HazenBabcock/revopoint-lat-lon-scanner/README.md

# revopoint-lat-lon-scanner

A two-axis stage that turns an object in front of a fixed Revopoint MINI 3D
scanner: a turntable (longitude) carried on a tilting cradle (latitude). Both
axes are stepper motors driven by a BigTreeTech SKR Mini E3 V3.0.

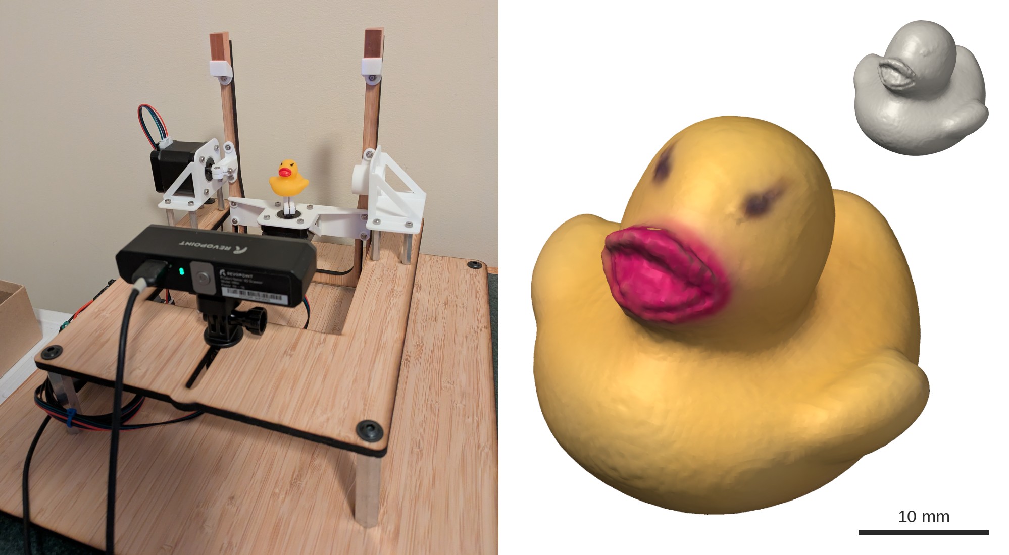
[picture p1: images/overview.jpg]
The stage with a rubber duck on the turntable, and the duck's scanned mesh in color and in gray


Left: the stage, with the scanner in front and a rubber duck on the turntable.
Right: the duck's mesh as the reconstruction builds it
([`examples/duck_color_mesh.ply`](examples/duck_color_mesh.ply)), colored from
the scanner's color camera. The same mesh without color (top right) shows the
scanned surface. The scale bar is for the color render. The
[example viewer](https://hazenbabcock.github.io/revopoint-lat-lon-scanner/examples/)
turns it around in 3D in the browser.

- [`firmware/`](firmware/) - Marlin configuration and build script for the
  board, which then takes G-code over USB. Licensed separately under the GPLv3.
- [`lat_lon_scanner/`](https://github.com/HazenBabcock/revopoint-lat-lon-scanner/tree/main/lat_lon_scanner) -
  Python package that drives the stage and the scanner.
- [`cad/`](cad/) - FreeCAD models of the stage, the DXF and STL files sent out
  for fabrication, and the bill of materials.
- [`examples/`](examples/) - some example scans, as point clouds and colored
  meshes, and a [3D viewer](https://hazenbabcock.github.io/revopoint-lat-lon-scanner/examples/)
  for them.
- [`notes/agent-guide.md`](notes/agent-guide.md) - a guide for AI agents working with this repository.

## Requirements

All access to the scanner goes through
[revopoint-python](https://github.com/HazenBabcock/revopoint-python), which
talks to the Revopoint MINI over WiFi: depth capture, exposure control and its
calibration files. It is not on PyPI, so install it from a checkout first:

```bash
git clone https://github.com/HazenBabcock/revopoint-python.git
pip install -e revopoint-python
```

Then install this package, with the extras for reconstruction and tests:

```bash
pip install -e ".[reconstruct,test]"
```

## Scanning

After powering up the stage, energize the motors, push the cradle upright by
hand (the motors hold it there), and declare that pose as zero:

```bash
python -m lat_lon_scanner.stage zero
```

Then scan. Each run goes to `~/Data/revopoint/<date>/<name>/`, with one `.npz`
per view holding the depth frames and stereo images at each exposure, and a
frame from the scanner's color camera (`--no-color` skips it). For color, light
the object with a steady lamp (see [Color](#color)):

```bash
python -m lat_lon_scanner.capture duck
```

The default plan is latitudes +90, +60, +30, 0 and −20, with each row's
longitudes spaced so neighboring views are about 30° of arc apart on the sphere
(`--spacing`): 1, 6, 10, 12 and 11 views, 40 in all at about 18 s each. Each
view captures 4 depth frames at each of three exposures (12000, 24000, 40000),
and the color frame during the 24000 one (or the exposure nearest it).

Those exposures suit yellow, red and darker objects. White and light objects
saturate at them: a white nylon part
([`examples/3d_printed_part_mesh.ply`](examples/3d_printed_part_mesh.ply)) got
depth on only 0.1–2% of each frame at 12000 and 24000, but 92–95% at any one
exposure from 2000 to 8000. Scan such objects with `--exposures 3000 6000`.

`python -m lat_lon_scanner.stage` also takes `position`,
`move <latitude> <longitude>` and `release`.

## Reconstruction

```bash
python -m lat_lon_scanner.reconstruct ~/Data/revopoint/<date>/duck
```

This needs the `reconstruct` extras (Open3D, SciPy) and writes
`reconstruction/` inside the run: `point_cloud.ply` (positions in mm, normals,
and color, or the scanner's grayscale brightness for runs without color
frames), `mesh.ply` (a triangle mesh fitted to the points, colored the same
way; `--no-mesh` skips it), `stage_axes.json`, `fit.npz`, and `preview_*.png` renderings
from six directions.

The stage needs no separate calibration. The two rotation axes are fitted from
the scan itself, by minimizing how far neighboring views disagree once each is
turned back by its commanded angles. On the first duck scan the axes came out
0.5 mm from intersecting, and neighboring views agreed to about 0.3 mm. Each
view is filtered (pixels at depth edges and surfaces seen nearly edge-on are
dropped), the views are merged, and the result is cropped to the object: the
post and cap it sits on are found as a stack of cylinders on the turntable axis
and cut away. Yellow surfaces reflect little of the scanner's blue light and
need long exposures. Some surfaces give little depth even then: the duck's pink
beak got depth on only 10–33% of its pixels in any one view at 60000, so expect
holes there.

The mesh is fitted with Poisson surface reconstruction, which bridges holes
like those in the beak. Poisson also closes the opening where the mount was
cut away, with surface no point supports, so the mesh is trimmed back to
within 1 mm of the points. Holes wider than about 2 mm keep an opening.

An object on a soft mount also tips as the cradle tilts. The bust, held on its
cap by a gel pad about 0.5 mm thick, leaned toward the scanner at high
latitudes and away at negative ones, which left its head in layers 1–2 mm
apart. So after the axes, the reconstruction fits a nod that grows with the
gravity load, gain × sin(latitude), about a pivot on the turntable axis, and
then refits the axes with it. For the bust the nod came out 2.5° at latitude 90,
and the misalignment of views up to 70° apart fell from 0.53 to 0.46 mm; for
the duck it was 0.5°, with little effect. The bust's 88 views take about 10
minutes to reconstruct, 5 of them for the nod.

A soft mount can also let the object shift in single views: the bust moved by
up to 2 mm during its +50 row. So each view's pose is then refined with a
joint ICP over neighboring views, starting from the fitted model
(`--no-refine` skips it; it takes a minute or two). On the bust the head's
surface went from layers about 0.3 mm thick to one layer under 0.1 mm; on the
duck it made little difference.

### Color

Each point of the cloud, and each vertex of the mesh, is colored from every
view's color frame that sees it. It is projected into the frame using the
color camera's calibration stored on the scanner. It counts as unseen if it
faces away or something nearer hides it (the color camera sits 15 mm from the
depth camera, so it sees around edges differently). The colors are white
balanced and averaged over the frames, each weighted by how squarely the
surface faces the camera. A point takes color even from views that got no
depth there, which matters for surfaces like the duck's beak. The color camera
only runs while the projector does, so its frames carry faint projector
stripes. These stay put in the frame while the object turns under them, so
averaging over views removes them.

Scan under a steady lamp aimed at the object from the scanner's side:

- The color camera's exposure and white balance are automatic and can't be
  set, so in daylight the colors drift as clouds pass.
- Next to a lamp the projector's light is weak. Without one it can dominate,
  and some dyes fluoresce in it: the duck's yellow came out green.

The white balance gains (`color_white_balance_gains` in `reconstruct.py`)
were measured from the gray patches of a color card held where the object sits,
under the lamp used for the duck. A different light needs new gains. The camera
also seems to see near-infrared, which mutes some colors (it reads a navy
patch as brown and a green one as gray), so a full color fit to the card's
patches did worse than the white balance alone. An LED lamp, with little
infrared, may give cleaner color than an incandescent one.

Now and then a whole session's frames have far less blue than those gains
expect, and the reconstruction warns about extreme cases. One such run turned a
light tan flower pot yellow-green and its light purple flowers tan, for no known
reason.
`--white-from-mount` then takes the white balance and brightness from the
run's own white nylon post and cap instead. It isn't the default because the
fixed gains look better on normal runs. A rescan after power-cycling the scanner
brought back normal color. Each view also records the white balance gains the
camera was using, and the reconstruction reports them.

### Filling in a dark area

A dark area, such as the duck's red beak, keeps getting depth at longer
exposures after the rest of the object has stopped improving. Rather than
rescanning everything, scan just that area at 60000 (the top of the scanner's
useful range) as a second run, without moving the scanner or re-zeroing the
stage, then merge it in:

```bash
python -m lat_lon_scanner.capture duck_beak --exposures 60000 \
    --poses "-15:-37 -15:-22 -15:-7 -15:8 -15:23 0:23 0:8 0:-7 0:-22 0:-37"
python -m lat_lon_scanner.reconstruct ~/Data/revopoint/<date>/duck \
    --extra-runs ~/Data/revopoint/<date>/duck_beak --output-name reconstruction_with_beak
```

The extra run's views are placed using the axes fitted from the main run. For
the duck, 20 views around the beak took 3 minutes, lined up with the main scan
as well as its own views do (about 0.1 mm), and nearly doubled the points
within 5 mm of the beak's center.

New angles are what help. Repeating a pose fills the same pixels again: three
captures of one beak pose together covered only 3–4 points more of it than the
best one alone. Turning the lamp off helped a little at 60000 (the beak got
depth on 24% and 33% of its pixels at two poses, against 21% and 27% with the
lamp), because the lamp adds brightness without adding stripe contrast. An
extra run's color frames color the object too, so capture a lamp-off run with
`--no-color`. What holes remain, the mesh bridges.

### Larger objects

The duck was scanned with the scanner at the front of its mount slot, which
puts the rotation center about 120 mm away; there the view is only about
54 mm tall. For a larger object, slide the scanner back along the slot. At the
back the rotation center is about 176 mm away, the view about 79 mm tall, and
a bust about 70 mm tall fit at every pose from latitude −20 to +90. The
scanner's working distance is 100–200 mm.

The reconstruction defaults are set for the duck, so give it the new distances:

```bash
python -m lat_lon_scanner.reconstruct ~/Data/revopoint/<date>/bust --depth-range 100 215 --crop-radius 55
```

`--depth-range` keeps depth readings between those distances from the scanner,
in mm (default 73–194). `--crop-radius` keeps points within that distance of
the rotation center, in mm (default 32).

### Round objects

The mount is found by its round cross-section, so a round object centered on
the turntable axis, such as a small flower pot, can pass for it and be cut
away. The reconstruction warns when the mount's top comes within 5 mm of the
rotation center. If the object lost its lower part, give the height of the
cap's top yourself, in mm along the turntable axis from the rotation center
(negative is below it). Everything above it is kept:

```bash
python -m lat_lon_scanner.reconstruct ~/Data/revopoint/<date>/flower_pot --mount-top -8.5
```

### Redoing only the last steps

Most of a reconstruction's time goes to fitting the stage and refining the
views. To change only what comes after, such as the mount cut or the white
balance, take those from an earlier output (its `fit.npz`) with `--reuse-fit`:

```bash
python -m lat_lon_scanner.reconstruct ~/Data/revopoint/<date>/flower_pot --reuse-fit reconstruction \
    --mount-top -8.5 --output-name reconstruction_with_pot
```

## Tests

```bash
python -m pytest tests
```

## Stage conventions

Positions are in degrees. Zero is the cradle upright (turntable axis vertical),
set with `G92 X0 Y0` after each power-up since there are no limit switches.

| Axis | Motion | Positive direction | Hard limit | Scanning range |
|---|---|---|---|---|
| X | Latitude (tilt) | Top of the stage tilts toward the scanner | ±90° | +90° to −20° |
| Y | Longitude (turntable) | Counterclockwise seen from above (cradle upright) | None | Any |

- The latitude hard limit is set by the longitude motor's cable, which winds
  onto the apparatus beyond ±90°.
- Below −20° the scanner mostly sees the underside of the mount and the
  turntable plate.
- Turning the object counterclockwise moves the scanner's viewpoint clockwise
  around it, so +Y lowers the viewpoint's longitude on the object.

## CAD

[`cad/`](cad/) has the FreeCAD 1.1 models of the stage, the files sent out for
fabrication, and the bill of materials
([`scanner_mount_bom.xlsx`](cad/scanner_mount_bom.xlsx)). The assemblies also use models that can't be redistributed
here, so FreeCAD opens them with those parts missing:

- The scanner, from [Revopoint Mini](https://grabcad.com/library/revopoint-mini-1)
  and [Revopoint - Pop 3 Set](https://grabcad.com/library/revopoint-pop-3-1) on
  GrabCAD.
- The control board, from BigTreeTech's
  [SKR Mini E3 repository](https://github.com/bigtreetech/BIGTREETECH-SKR-mini-E3/tree/master/hardware/BTT%20SKR%20MINI%20E3%20V3.0/3D).
- The example object, from
  [Small bust scanned with Revopoint MINI](https://grabcad.com/library/small-bust-scanned-with-revopoint-mini-1)
  on GrabCAD.
- The motors and hardware, from McMaster-Carr.

[`cad/README.md`](cad/README.md) lists each missing file and McMaster-Carr part
number.

## License

MIT (see `LICENSE`), except `firmware/`, which is derived from Marlin and
licensed under the GPLv3 (see `firmware/LICENSE`).
