HazenBabcock/revopoint-lat-lon-scanner/cad/scanner_mount_bom.xlsx

Sheet: McMaster order
Revopoint scanner mount - McMaster-Carr order list
Quantities are for one complete build, counted from every instance in assembly.FCStd (model saved 11 Oct 2026). The copper bar and the washers are added by hand (see Notes).
Qty | Part number | Type | Description | Size | Where used
Screws
4 | 91292A109 | Screw | 18-8 stainless socket head cap screw | M3 x 0.5 mm, 4 mm long | M3 x 8 mm standoff kit
16 | 91292A111 | Screw | 18-8 stainless socket head cap screw | M3 x 0.5 mm, 6 mm long | M3 x 31 mm standoff kit; Latitude stepper motor assembly; Longitude stepper motor assembly
2 | 91292A112 | Screw | 18-8 stainless socket head cap screw | M3 x 0.5 mm, 8 mm long | Lat/lon stage assembly; Longitude stepper mount assembly
12 | 91292A113 | Screw | 18-8 stainless socket head cap screw | M3 x 0.5 mm, 10 mm long | M3 x 8 mm standoff kit; M3 x 31 mm standoff kit
10 | 91292A114 | Screw | 18-8 stainless socket head cap screw | M3 x 0.5 mm, 12 mm long | Lat/lon stage assembly; Longitude stepper mount assembly
12 | 91355A081 | Screw | Black-oxide alloy steel flanged button head screw | 1/4"-20, 1/2" long | Foot bumper; 1/4"-20 x 63.5 mm standoff kit
Nuts
12 | 94150A325 | Nut | 316 stainless hex nut | M3 x 0.5 mm, 5.5 mm wide, 2.4 mm thick | Lat/lon stage assembly; Longitude stepper mount assembly
Washers
2 | 96659A106 | Washer | 18-8 stainless SAE washer | 1/4" screw size, 0.281" ID, 0.625" OD | Scanner mount (not modeled)
Standoffs
4 | 95947A004 | Standoff | Aluminum female-threaded hex standoff | M3 x 0.5 mm, 8 mm long, 4.5 mm hex | M3 x 8 mm standoff kit
8 | 95947A063 | Standoff | Aluminum female-threaded hex standoff | M3 x 0.5 mm, 31 mm long, 6 mm hex | M3 x 31 mm standoff kit
4 | 91780A363 | Standoff | Aluminum female-threaded hex standoff | 1/4"-20, 2-1/2" (63.5 mm) long, 1/2" hex | 1/4"-20 x 63.5 mm standoff kit
Bumpers
4 | 9546K551 | Bumper | Neoprene bumper, threaded stud/insert | 3/4" dia x 5/8" high, 1/4"-20 | Foot bumper
Knobs
1 | 7129T33 | Knob | Black phenolic five-arm knob | 32.6 mm across arms, approx. 5/16" threaded bore | Top level (assembly)
Bar stock
1 | 89275K36 | Bar | Multipurpose 110 copper bar | 1/2" thick, 1/2" wide, 1/2 ft (6") long | Counterweights: cut into two ~1.25" (32 mm) pieces
92 |  |  | Total McMaster pieces

Sheet: Full BOM
Revopoint scanner mount - full bill of materials
Qty | Part ref. | Type | Description | Size | Source
McMaster-Carr hardware
4 | 9546K551 | Bumper | Neoprene bumper, threaded stud/insert | 3/4" dia x 5/8" high, 1/4"-20 | McMaster-Carr
1 | 7129T33 | Knob | Black phenolic five-arm knob | 32.6 mm across arms, approx. 5/16" threaded bore | McMaster-Carr
12 | 94150A325 | Nut | 316 stainless hex nut | M3 x 0.5 mm, 5.5 mm wide, 2.4 mm thick | McMaster-Carr
16 | 91292A111 | Screw | 18-8 stainless socket head cap screw | M3 x 0.5 mm, 6 mm long | McMaster-Carr
12 | 91292A113 | Screw | 18-8 stainless socket head cap screw | M3 x 0.5 mm, 10 mm long | McMaster-Carr
12 | 91355A081 | Screw | Black-oxide alloy steel flanged button head screw | 1/4"-20, 1/2" long | McMaster-Carr
10 | 91292A114 | Screw | 18-8 stainless socket head cap screw | M3 x 0.5 mm, 12 mm long | McMaster-Carr
4 | 91292A109 | Screw | 18-8 stainless socket head cap screw | M3 x 0.5 mm, 4 mm long | McMaster-Carr
2 | 91292A112 | Screw | 18-8 stainless socket head cap screw | M3 x 0.5 mm, 8 mm long | McMaster-Carr
8 | 95947A063 | Standoff | Aluminum female-threaded hex standoff | M3 x 0.5 mm, 31 mm long, 6 mm hex | McMaster-Carr
4 | 91780A363 | Standoff | Aluminum female-threaded hex standoff | 1/4"-20, 2-1/2" (63.5 mm) long, 1/2" hex | McMaster-Carr
4 | 95947A004 | Standoff | Aluminum female-threaded hex standoff | M3 x 0.5 mm, 8 mm long, 4.5 mm hex | McMaster-Carr
2 | 96659A106 | Washer | 18-8 stainless SAE washer | 1/4" screw size, 0.281" ID, 0.625" OD | McMaster-Carr
Laser-cut plates
1 |  | Plate | Base plate | 374 x 352 x 6.7 mm | Ponoko - 6.7mm Amber Bamboo Plywood - Laser Cutting
1 |  | Plate | Lat/lon plate | 230 x 140 x 6.7 mm | Ponoko - 6.7mm Amber Bamboo Plywood - Laser Cutting
1 |  | Plate | Scanner mount plate | 268 x 228 x 6.7 mm | Ponoko - 6.7mm Amber Bamboo Plywood - Laser Cutting
3D printed parts
2 |  | Printed part | Counterweight clamp | 22.5 x 14.9 x 14.7 mm | Xometry - Nylon 12, White, Color: As Printed, Off White (Natural)
2 |  | Printed part | Latitude stepper mount | 76 x 40 x 50 mm | Xometry - Nylon 12, White, Color: As Printed, Off White (Natural)
1 |  | Printed part | Longitude stepper mount | 138 x 30 x 50 mm | Xometry - Nylon 12, White, Color: As Printed, Off White (Natural)
1 |  | Printed part | Latitude idle arm | 37.8 x 40 x 23 mm | Xometry - Nylon 12, White, Color: As Printed, Off White (Natural)
1 |  | Printed part | Latitude stepper arm | 38.0 x 40 x 16 mm | Xometry - Nylon 12, White, Color: As Printed, Off White (Natural)
1 |  | Printed part | Longitude plate | 20.0 x 15 x 20 mm | Xometry - Nylon 12, White, Color: As Printed, Off White (Natural)
Cut from bar stock
2 |  | Bar stock | Counterweight, cut from copper bar | 1/2" x 1/2" x about 1.25" (32 mm) long | Cut from McMaster-Carr 89275K36 (see McMaster order)
Purchased electronics and motors
1 |  | Electronics | BigTreeTech SKR Mini E3 V3.0 stepper controller board | 105.3 x 70.3 x 18.2 mm | Purchased
1 |  | Motor | STEPPERONLINE Nema 17 stepper motor, bipolar, 4-lead | 2 A, 55 Ncm, 1.8° step | STEPPERONLINE (modeled as McMaster 6627T67)
1 |  | Motor | STEPPERONLINE Nema 17 pancake stepper motor, bipolar, 4-lead | 1 A, 17 Ncm, 1.8° step | STEPPERONLINE (modeled as McMaster 6627T64)
2 |  | Cable | Stepper motor cable, XH2.54 4-pin to 6-pin | 1.5 m | Amazon, sold in 3-packs (one pack covers both motors)
1 |  | Power supply | 24 V DC power supply for the control board | 6 A, 100-240 V AC in, 5.5 x 2.1 mm jack with terminal connector | Amazon
Reference geometry (not purchased)
1 |  | Reference | Revopoint scanner clamp joint | - | Reference geometry - not purchased
1 |  | Reference | Revopoint Mini scanner body | - | Reference geometry - not purchased
1 |  | Reference | Revopoint Mini tripod mount | - | Reference geometry - not purchased
1 |  | Reference | Revopoint scanner tripod receiver | - | Reference geometry - not purchased
1 |  | Reference | Scan test object (small bust) | 34.3 x 32.5 x 65.0 mm | Reference geometry - not purchased
115 |  |  | Total part instances in the build

Sheet: Notes
How this BOM was produced
Source: assembly.FCStd, saved 11 Oct 2026 14:45.
The whole assembly was opened in FreeCAD and every sub-assembly expanded, giving 108 individual part instances.
Quantities on the "By sub-assembly" tab are the counted inputs (blue); every other quantity in this workbook is a formula.
Fastener sizes were measured from the solid geometry, not taken from the part number:
- For socket head cap screws, length = overall length along the screw axis minus the measured 3.0 mm head height,
and the thread diameter is twice the measured shank radius. All five screws fall on the 91292A1xx M3 series
(A109 = 4 mm, A111 = 6 mm, A112 = 8 mm, A113 = 10 mm, A114 = 12 mm), which matches the measurements exactly.
- 91355A081 measures 15.80 mm overall over a 6.35 mm (1/4") shank, i.e. 1/4"-20 x 1/2" under a ~3.1 mm button head.
- 91780A363 measures 63.5 mm (2-1/2") long over a 12.4 mm (1/2") hex with a 1/4" bore, matching the
"standoff_q20_63mm" file name.
- 95947A063 measures exactly 31.0 mm long over a 6 mm hex with an M3 bore.
Things to check before ordering:
- The five-arm knob (7129T33) has an approx. 7.9 mm (5/16") bore in the model. The knob is not jointed to anything
in the assembly, so its thread could not be confirmed from the geometry - confirm it against the McMaster listing.
- Apart from the motor cables, power supply and washers added below, the BOM has no wiring, belts, connectors or
fasteners for the SKR Mini E3 board beyond the four M3 standoff kits.
- The Revopoint scanner parts and the "small_head" test object are reference geometry, not items to buy.
Added by hand on 27, 28 and 29 Oct 2026, not counted from the model:
- Counterweights: two ~1.25" (32 mm) pieces of 1/2" x 1/2" copper bar (McMaster-Carr 89275K36, 6" long), one held
in each counterweight clamp. The McMaster order rounds the pieces up to whole 6" bars, so one bar makes both.
- Motors: the model uses McMaster 6627T64 (longitude) and 6627T67 (latitude) as stand-ins, because they had CAD files.
The build uses a STEPPERONLINE Nema 17 pancake motor (1 A, 17 Ncm) for longitude and a STEPPERONLINE Nema 17
(2 A, 55 Ncm) for latitude, both bipolar, 1.8° step, 4-lead. They come from STEPPERONLINE, not McMaster-Carr.
- Motor cables: two 1.5 m stepper motor cables, XH2.54 4-pin to 6-pin, from Amazon, where they come in 3-packs
("3Pcs 1.5M Stepper Motor Cables XH2.54 4Pin to 6Pin Terminal Motor Wires ..."). One pack covers both motors.
- Power supply (28 Oct): one 24 V, 6 A AC adapter (100-240 V AC in) for the SKR Mini E3 board, from Amazon:
"24V Power Supply, 24 Volt 6 Amp AC DC Adapter 100V-240V AC to 24V DC Power Supply with LED Terminal Connector,
5A 4A 3A 2A 1A DC Adapter with 5.5x2.1mm Jack".
- Washers (29 Oct): two 18-8 stainless SAE washers for 1/4" screws (0.281" ID, 0.625" OD), McMaster-Carr 96659A106,
used in mounting the scanner. The model doesn't show them.
- counter_weight.FCStd (exported to Xometry on 10 Oct) was an earlier counterweight design and is not part of the build.
All 14 STEP files in the project's mcmaster/ folder are used in the model. Twelve are on the McMaster order; the other
two are the stand-in motors.

Sheet: By sub-assembly
Sub-assembly | Source file | Instances in build | Part ref. | Description | Qty per instance | Total qty
Top level (assembly) | assembly.FCStd | 1 | 7129T33 | Black phenolic five-arm knob - 32.6 mm across arms, approx. 5/16" threaded bore | 1 | 1
Top level (assembly) | assembly.FCStd | 1 |  | Scanner mount plate - 268 x 228 x 6.7 mm | 1 | 1
Top level (assembly) | (not modeled) | 1 | 96659A106 | 18-8 stainless SAE washer - 1/4" screw size, 0.281" ID, 0.625" OD | 2 | 2
Top level (assembly) | assembly.FCStd | 1 |  | Scan test object (small bust) - 34.3 x 32.5 x 65.0 mm | 1 | 1
Base plate assembly | base_plate_assembly.FCStd | 1 |  | BigTreeTech SKR Mini E3 V3.0 stepper controller board - 105.3 x 70.3 x 18.2 mm | 1 | 1
Base plate assembly | base_plate_assembly.FCStd | 1 |  | Base plate - 374 x 352 x 6.7 mm | 1 | 1
Foot bumper | bumper.FCStd | 4 | 9546K551 | Neoprene bumper, threaded stud/insert - 3/4" dia x 5/8" high, 1/4"-20 | 1 | 4
Foot bumper | bumper.FCStd | 4 | 91355A081 | Black-oxide alloy steel flanged button head screw - 1/4"-20, 1/2" long | 1 | 4
M3 x 8 mm standoff kit | standoff_m3_8mm.FCStd | 4 | 91292A109 | 18-8 stainless socket head cap screw - M3 x 0.5 mm, 4 mm long | 1 | 4
M3 x 8 mm standoff kit | standoff_m3_8mm.FCStd | 4 | 91292A113 | 18-8 stainless socket head cap screw - M3 x 0.5 mm, 10 mm long | 1 | 4
M3 x 8 mm standoff kit | standoff_m3_8mm.FCStd | 4 | 95947A004 | Aluminum female-threaded hex standoff - M3 x 0.5 mm, 8 mm long, 4.5 mm hex | 1 | 4
1/4"-20 x 63.5 mm standoff kit | standoff_q20_63mm.FCStd | 4 | 91355A081 | Black-oxide alloy steel flanged button head screw - 1/4"-20, 1/2" long | 2 | 8
1/4"-20 x 63.5 mm standoff kit | standoff_q20_63mm.FCStd | 4 | 91780A363 | Aluminum female-threaded hex standoff - 1/4"-20, 2-1/2" (63.5 mm) long, 1/2" hex | 1 | 4
Latitude stepper mount assembly | stepper_lat_assembly.FCStd | 2 |  | Latitude stepper mount - 76 x 40 x 50 mm | 1 | 2
M3 x 31 mm standoff kit | standoff_m3_31mm.FCStd | 8 | 91292A111 | 18-8 stainless socket head cap screw - M3 x 0.5 mm, 6 mm long | 1 | 8
M3 x 31 mm standoff kit | standoff_m3_31mm.FCStd | 8 | 91292A113 | 18-8 stainless socket head cap screw - M3 x 0.5 mm, 10 mm long | 1 | 8
M3 x 31 mm standoff kit | standoff_m3_31mm.FCStd | 8 | 95947A063 | Aluminum female-threaded hex standoff - M3 x 0.5 mm, 31 mm long, 6 mm hex | 1 | 8
Latitude stepper motor assembly | stepper_lat.FCStd | 1 |  | STEPPERONLINE Nema 17 stepper motor, bipolar, 4-lead - 2 A, 55 Ncm, 1.8° step | 1 | 1
Latitude stepper motor assembly | stepper_lat.FCStd | 1 | 91292A111 | 18-8 stainless socket head cap screw - M3 x 0.5 mm, 6 mm long | 4 | 4
Lat/lon stage assembly | lat_lon_assembly.FCStd | 1 | 94150A325 | 316 stainless hex nut - M3 x 0.5 mm, 5.5 mm wide, 2.4 mm thick | 7 | 7
Lat/lon stage assembly | lat_lon_assembly.FCStd | 1 |  | Lat/lon plate - 230 x 140 x 6.7 mm | 1 | 1
Lat/lon stage assembly | lat_lon_assembly.FCStd | 1 |  | Counterweight clamp - 22.5 x 14.9 x 14.7 mm | 2 | 2
Lat/lon stage assembly | lat_lon_assembly.FCStd | 1 |  | Latitude idle arm - 37.8 x 40 x 23 mm | 1 | 1
Lat/lon stage assembly | lat_lon_assembly.FCStd | 1 |  | Latitude stepper arm - 38.0 x 40 x 16 mm | 1 | 1
Lat/lon stage assembly | (not modeled) | 1 |  | Counterweight, cut from copper bar - 1/2" x 1/2" x about 1.25" (32 mm) long | 2 | 2
Lat/lon stage assembly | lat_lon_assembly.FCStd | 1 | 91292A112 | 18-8 stainless socket head cap screw - M3 x 0.5 mm, 8 mm long | 1 | 1
Lat/lon stage assembly | lat_lon_assembly.FCStd | 1 | 91292A114 | 18-8 stainless socket head cap screw - M3 x 0.5 mm, 12 mm long | 6 | 6
Longitude stepper mount assembly | stepper_lon_assembly.FCStd | 1 | 94150A325 | 316 stainless hex nut - M3 x 0.5 mm, 5.5 mm wide, 2.4 mm thick | 5 | 5
Longitude stepper mount assembly | stepper_lon_assembly.FCStd | 1 |  | Longitude stepper mount - 138 x 30 x 50 mm | 1 | 1
Longitude stepper mount assembly | stepper_lon_assembly.FCStd | 1 |  | Longitude plate - 20.0 x 15 x 20 mm | 1 | 1
Longitude stepper mount assembly | stepper_lon_assembly.FCStd | 1 | 91292A112 | 18-8 stainless socket head cap screw - M3 x 0.5 mm, 8 mm long | 1 | 1
Longitude stepper mount assembly | stepper_lon_assembly.FCStd | 1 | 91292A114 | 18-8 stainless socket head cap screw - M3 x 0.5 mm, 12 mm long | 4 | 4
Longitude stepper motor assembly | stepper_lon.FCStd | 1 |  | STEPPERONLINE Nema 17 pancake stepper motor, bipolar, 4-lead - 1 A, 17 Ncm, 1.8° step | 1 | 1
Longitude stepper motor assembly | stepper_lon.FCStd | 1 | 91292A111 | 18-8 stainless socket head cap screw - M3 x 0.5 mm, 6 mm long | 4 | 4
Wiring | (not modeled) | 1 |  | Stepper motor cable, XH2.54 4-pin to 6-pin - 1.5 m | 2 | 2
Wiring | (not modeled) | 1 |  | 24 V DC power supply for the control board - 6 A, 100-240 V AC in, 5.5 x 2.1 mm jack with terminal connector | 1 | 1
Revopoint scanner (reference) | revopoint_assembled.FCStd | 1 |  | Revopoint scanner clamp joint | 1 | 1
Revopoint scanner (reference) | revopoint_assembled.FCStd | 1 |  | Revopoint Mini scanner body | 1 | 1
Revopoint scanner (reference) | revopoint_assembled.FCStd | 1 |  | Revopoint Mini tripod mount | 1 | 1
Revopoint scanner (reference) | revopoint_assembled.FCStd | 1 |  | Revopoint scanner tripod receiver | 1 | 1
 |  |  |  |  | Total part instances | 115
