HazenBabcock/revopoint-lat-lon-scanner/cad/exports/parts_2D_DXF/scanner_mount_plate-Shape2DView.dxf

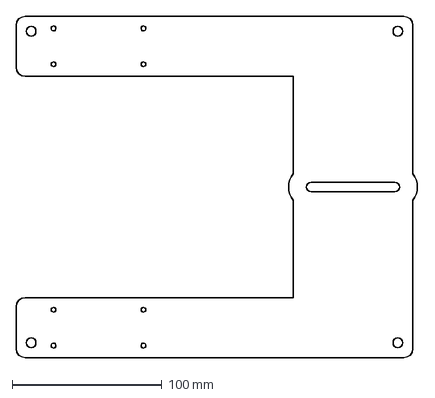
[picture p4: CAD file, 2026-10-28]
cad/exports/parts_2D_DXF/scanner_mount_plate-Shape2DView.dxf
269.0 x 228.0 mm
