HazenBabcock/revopoint-lat-lon-scanner/cad/exports/parts_3D_STL/lat_stepper_arm-Body_lat_idle_arm.stl

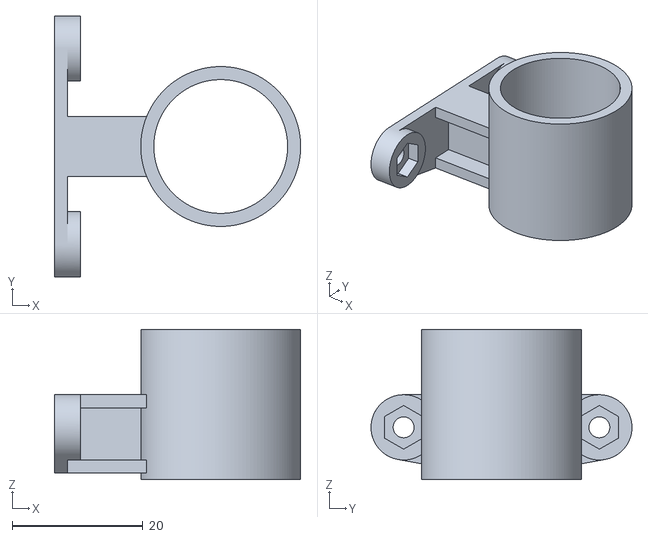
[picture p5: CAD file, 2026-10-28]
cad/exports/parts_3D_STL/lat_stepper_arm-Body_lat_idle_arm.stl
37.8 x 40.0 x 23.0
