HazenBabcock/revopoint-lat-lon-scanner/examples/3d_printed_part_mesh.ply

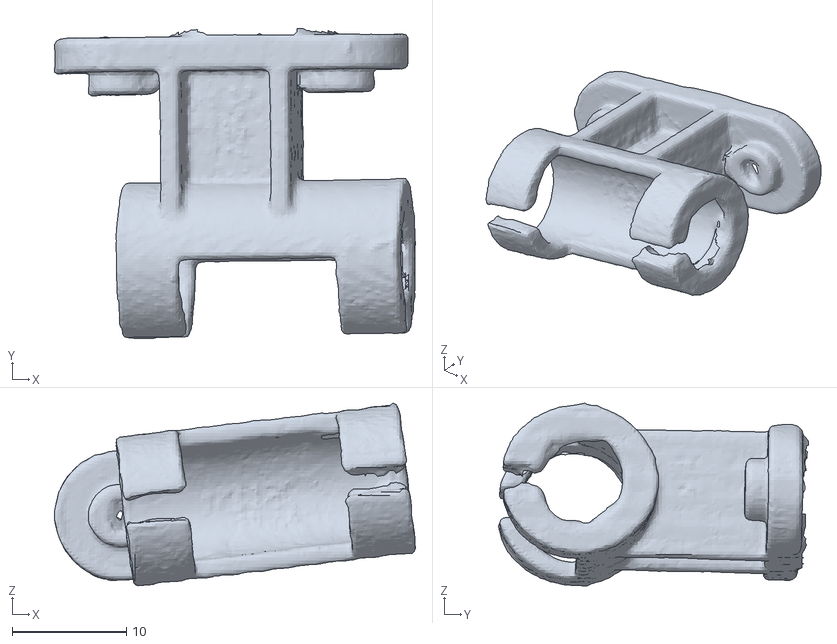
[picture p6: CAD file, 2026-10-29]
examples/3d_printed_part_mesh.ply
31.6 x 27.2 x 16.0
