HazenBabcock/revopoint-lat-lon-scanner/cad/exports/parts_2D_DXF/lat_lon_plate-Shape2DView.dxf

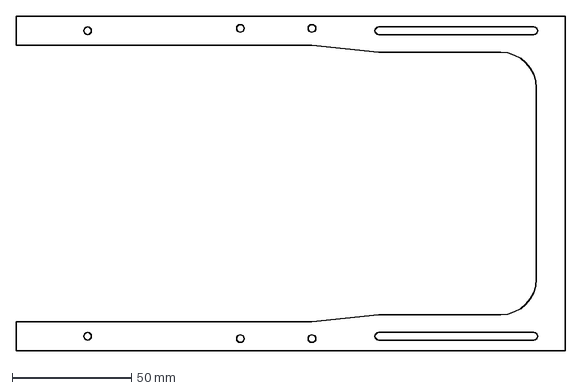
[picture p7: CAD file, 2026-10-28]
cad/exports/parts_2D_DXF/lat_lon_plate-Shape2DView.dxf
230.0 x 140.0 mm
