HazenBabcock/revopoint-lat-lon-scanner/cad/exports/parts_3D_STL/stepper_lat_mount-Body_stepper_lat_mount.stl

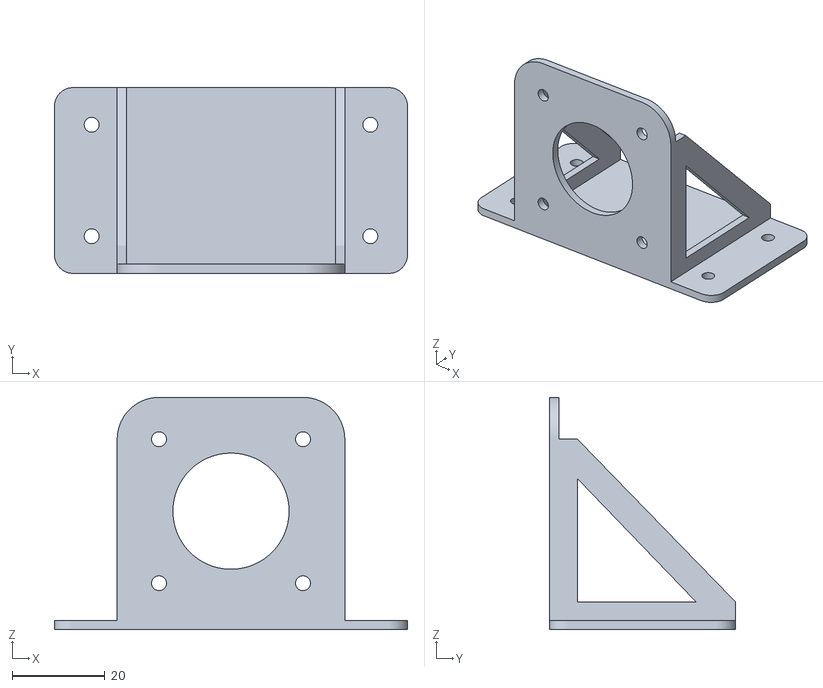
[picture p8: CAD file, 2026-10-28]
cad/exports/parts_3D_STL/stepper_lat_mount-Body_stepper_lat_mount.stl
76.0 x 40.0 x 50.0
