HazenBabcock/revopoint-lat-lon-scanner/cad/stepper_lon_mount.FCStd

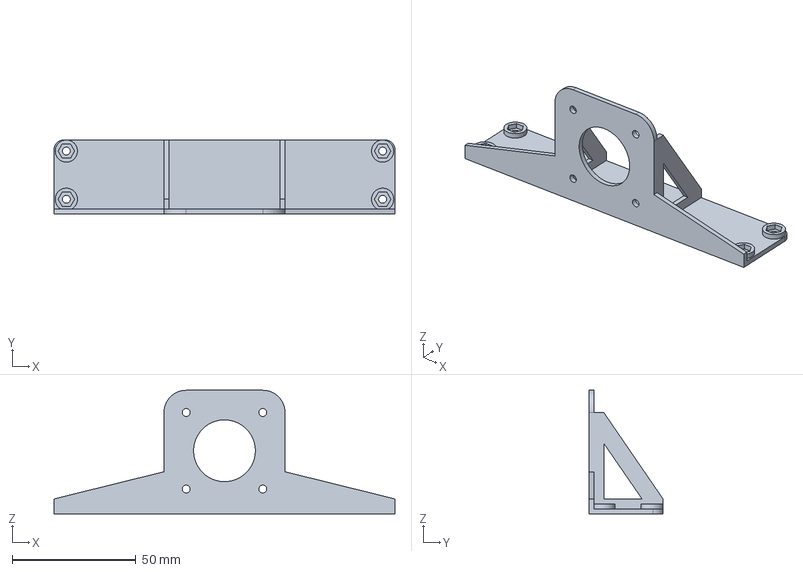
[picture p9: CAD file, 2026-10-28]
cad/stepper_lon_mount.FCStd
138.0 x 30.0 x 50.0 mm
