HazenBabcock/revopoint-lat-lon-scanner/examples/duck_color_mesh.ply

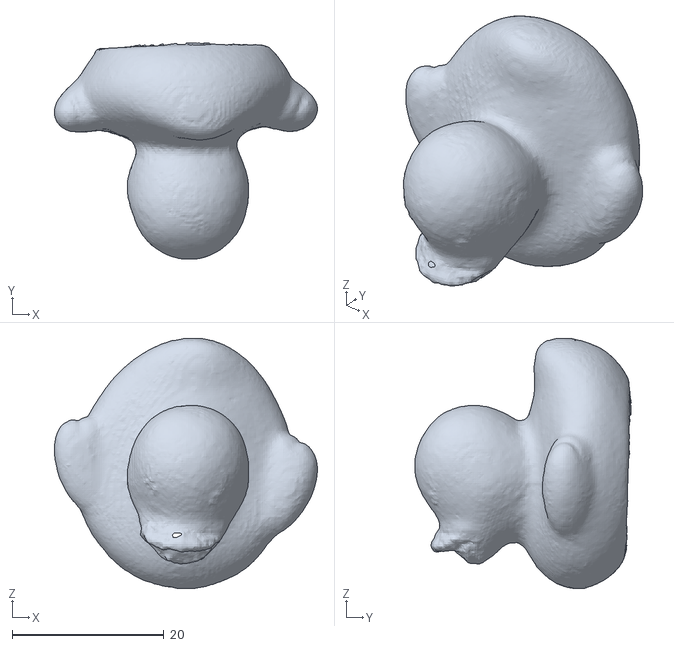
[picture p10: CAD file, 2026-10-28]
examples/duck_color_mesh.ply
34.7 x 28.5 x 33.0
