HazenBabcock/revopoint-lat-lon-scanner/cad/exports/parts_2D_DXF/base_plate-Shape2DView.dxf

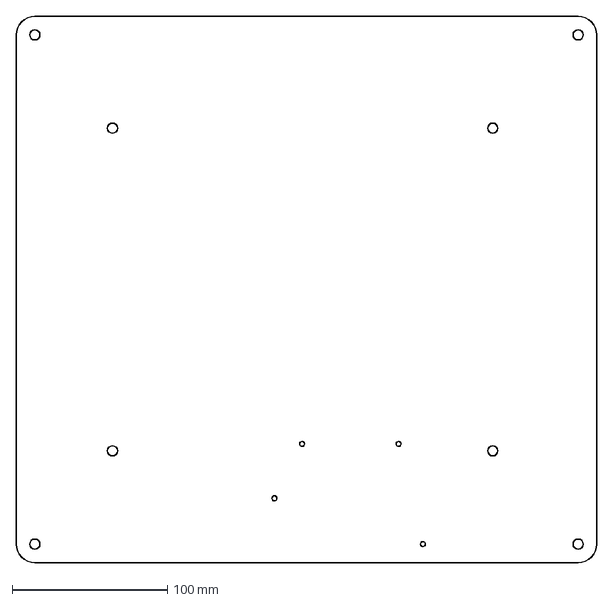
[picture p11: CAD file, 2026-10-28]
cad/exports/parts_2D_DXF/base_plate-Shape2DView.dxf
374.0 x 352.0 mm
