HazenBabcock/revopoint-lat-lon-scanner/cad/exports/parts_3D_STL/lat_stepper_arm-Body_lat_stepper_arm.stl

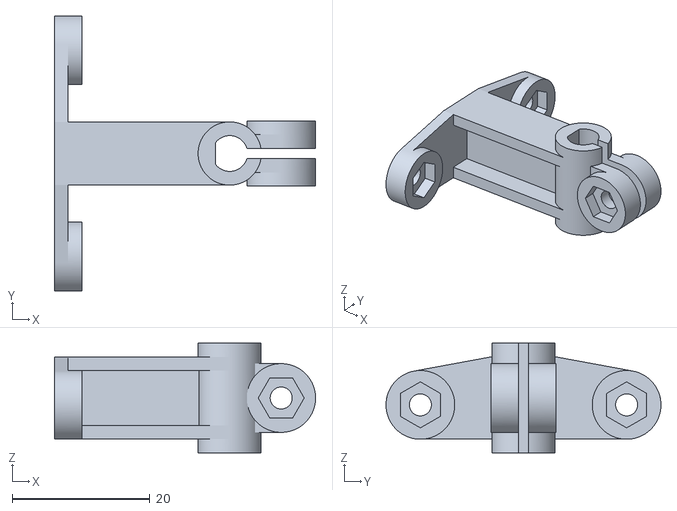
[picture p12: CAD file, 2026-10-28]
cad/exports/parts_3D_STL/lat_stepper_arm-Body_lat_stepper_arm.stl
38.0 x 40.0 x 16.0
