HazenBabcock/revopoint-lat-lon-scanner/cad/lon_plate.FCStd

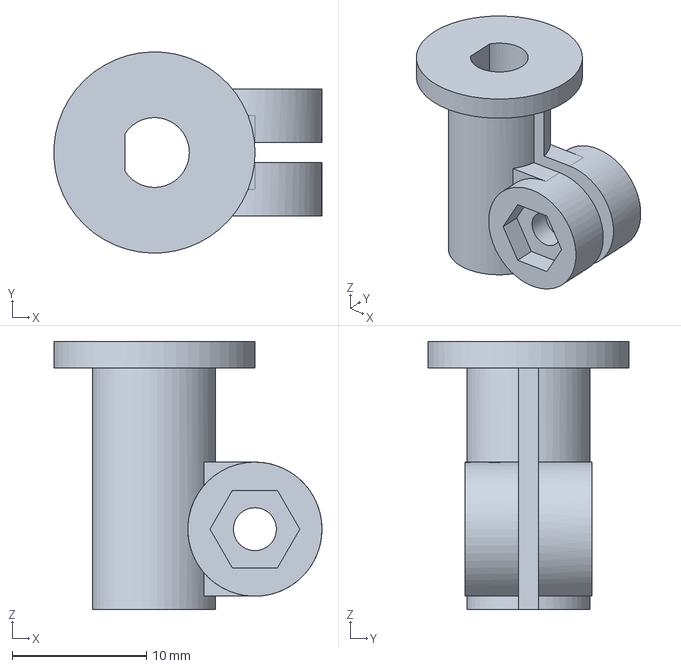
[picture p13: CAD file, 2026-10-28]
cad/lon_plate.FCStd
20.0 x 15.0 x 20.0 mm
