HazenBabcock/revopoint-lat-lon-scanner/cad/counter_weight_clamp.FCStd

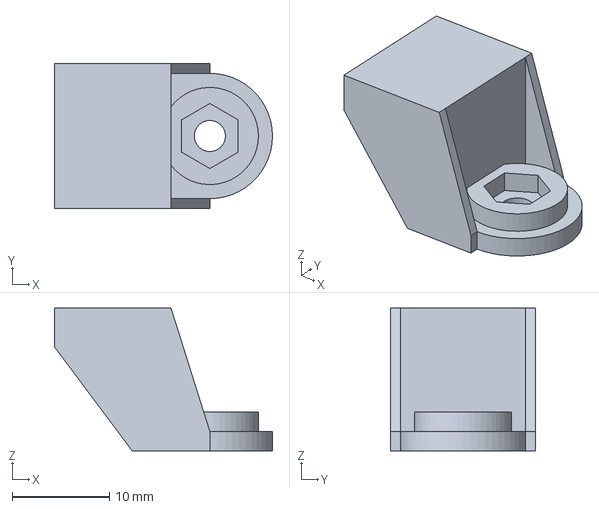
[picture p14: CAD file, 2026-10-28]
cad/counter_weight_clamp.FCStd
22.5 x 14.9 x 14.7 mm
