HazenBabcock/revopoint-lat-lon-scanner/cad/lat_stepper_arm.FCStd

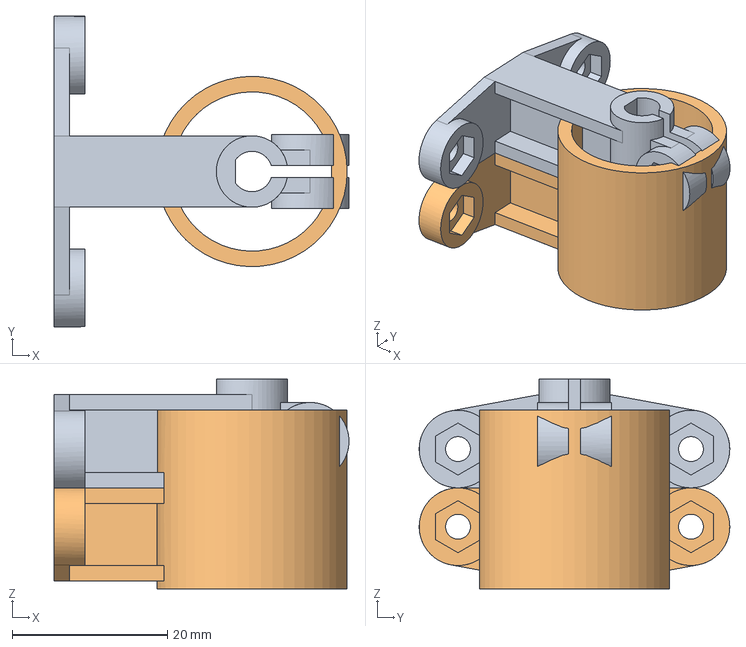
[picture p15: CAD file, 2026-10-28]
cad/lat_stepper_arm.FCStd
38.0 x 40.0 x 27.0 mm
Body_lat_stepper_arm
Body_lat_idle_arm
