HazenBabcock/revopoint-lat-lon-scanner/(list of files, cad)

Other CAD files:
cad/stepper_lat_assembly.FCStd
cad/assembly.FCStd
cad/lat_lon_assembly.FCStd
cad/base_plate_assembly.FCStd
cad/stepper_lon_assembly.FCStd
examples/bust_point_cloud.ply
cad/bumper.FCStd
cad/exports/parts_3D_STL/stepper_lon_mount-Body.stl
examples/duck_point_cloud.ply
cad/exports/parts_3D_STL/lon_plate-Body_lon_plate.stl
cad/exports/parts_3D_STL/counter_weight_clamp-Body_cw_clamp.stl
cad/base_plate.FCStd
cad/stepper_lat.FCStd
cad/stepper_lat_mount.FCStd
cad/scanner_mount_plate.FCStd
cad/lat_lon_plate.FCStd
cad/standoff_q20_63mm.FCStd
cad/stepper_lon.FCStd
