HazenBabcock/revopoint-lat-lon-scanner/firmware/config/Configuration_adv.h

  #define CONTROLLER_FAN_PIN FAN2_PIN       // Set a custom pin for the controller fan
#define E0_AUTO_FAN_PIN FAN1_PIN
#define E1_AUTO_FAN_PIN -1
#define E2_AUTO_FAN_PIN -1
#define E3_AUTO_FAN_PIN -1
#define E4_AUTO_FAN_PIN -1
#define E5_AUTO_FAN_PIN -1
#define E6_AUTO_FAN_PIN -1
#define E7_AUTO_FAN_PIN -1
#define CHAMBER_AUTO_FAN_PIN -1
#define COOLER_AUTO_FAN_PIN -1
#define HOMING_BUMP_MM      { 5, 5 }          // (linear=mm, rotational=°) Backoff from endstops after first bump
#define HOMING_BUMP_DIVISOR { 2, 2 }          // Re-Bump Speed Divisor (Divides the Homing Feedrate)
#define QUICK_HOME                            // If G28 contains XY do a diagonal move first
#define MICROSTEP_MODES { 16, 16, 16, 16, 16, 16 } // [1,2,4,8,16]
    #define X_CURRENT       800        // (mA) RMS. Latitude: STEPPERONLINE 2 A / 55 Ncm, 57% of its 1414 mA RMS ceiling.
    #define X_CURRENT_HOME  (X_CURRENT/2)  // (mA) RMS current for homing. (Typically lower than *_CURRENT.)
    #define X_MICROSTEPS     16        // 0..256
    #define Y_CURRENT       480        // (mA) RMS. Longitude: STEPPERONLINE 1 A / 17 Ncm pancake, 68% of its 707 mA RMS ceiling.
    #define Y_CURRENT_HOME  (Y_CURRENT/2)
    #define Y_MICROSTEPS     16
    #define CURRENT_STEP_DOWN     50  // [mA]
    #define REPORT_CURRENT_CHANGE
  #define X_HYBRID_THRESHOLD     100  // [mm/s]
  #define X2_HYBRID_THRESHOLD    100
  #define Y_HYBRID_THRESHOLD     100
  #define Y2_HYBRID_THRESHOLD    100
  #define Z_HYBRID_THRESHOLD       3
  #define Z2_HYBRID_THRESHOLD      3
  #define Z3_HYBRID_THRESHOLD      3
  #define Z4_HYBRID_THRESHOLD      3
  #define I_HYBRID_THRESHOLD       3  // [linear=mm/s, rotational=°/s]
  #define J_HYBRID_THRESHOLD       3  // [linear=mm/s, rotational=°/s]
  #define K_HYBRID_THRESHOLD       3  // [linear=mm/s, rotational=°/s]
  #define U_HYBRID_THRESHOLD       3  // [mm/s]
  #define V_HYBRID_THRESHOLD       3
  #define W_HYBRID_THRESHOLD       3
  #define E0_HYBRID_THRESHOLD     30
  #define E1_HYBRID_THRESHOLD     30
  #define E2_HYBRID_THRESHOLD     30
  #define E3_HYBRID_THRESHOLD     30
  #define E4_HYBRID_THRESHOLD     30
  #define E5_HYBRID_THRESHOLD     30
  #define E6_HYBRID_THRESHOLD     30
  #define E7_HYBRID_THRESHOLD     30
