HazenBabcock/revopoint-lat-lon-scanner/lat_lon_scanner/reconstruct.py

"""
Build a point cloud of the scanned object from a capture run.

    python -m lat_lon_scanner.reconstruct ~/Data/revopoint/<date>/<name>

Steps:

1. Each view's exposures are merged into one depth map (the median of the
   valid frames, dropping pixels where exposures disagree), pixels near holes
   and depth jumps are dropped, and the rest are turned into points in
   millimetres using the scanner's rectified left camera. Surfaces seen nearly
   edge-on are dropped too.
2. The two stage axes are fitted in the camera frame by minimizing the
   misalignment between neighboring views once each is rotated back by its
   commanded angles. The object frame is the camera frame at latitude 0,
   longitude 0. Then a nod of the object that grows with the gravity load,
   sin(latitude), about a pivot on the turntable axis is fitted (an object on
   a soft mount tips as the cradle tilts), and the axes are refitted with it.
3. Each view's pose is refined with a joint (multiway) ICP that starts from
   the fitted model (--no-refine skips it). An object on a soft mount can also
   shift in single views: the bust shifted by up to 2 mm during one row,
   likely on its gel pad, and the refinement merged the layers that left
   (misalignment 0.426 -> 0.324 mm). On the duck it made no difference.
4. All views are merged and cropped to the object: a sphere around the
   rotation center, with the post and cap it sits on cut away (--mount-top
   sets the height for a round object that passes for the mount). The result
   is thinned, cleaned of stray points and disconnected fragments, and given
   surface normals.
5. If the run has color frames, each final point is colored from every
   color frame that sees it (projected through the color camera's
   calibration; hidden or facing away counts as unseen), white balanced, and
   averaged over those frames. The projector's stripes, fixed in the color
   frames while the object moves under them, average out.
6. A mesh is fitted to the points (Poisson surface reconstruction), bridging
   the small holes the scan left, trimmed back to where the points are, and
   colored from the frames the same way (--no-mesh skips it).

Results go to <run>/reconstruction/ (or --output-name): point_cloud.ply
(points, normals, and color, or the scanner's grayscale brightness for runs
without color frames), mesh.ply (vertices with normals and the same kind of
color, and triangles), stage_axes.json, fit.npz (the stage fit and each view's
pose, which --reuse-fit takes from an earlier output to skip steps 2 and 3), and
preview_*.png renderings. --extra-runs merges in more
runs of the same object, such as a close-up of one area at a longer exposure,
placed using the main run's fitted axes.
"""
import argparse
import json
import os
import pathlib
import shutil
import struct
import sys
import time
import warnings

import numpy as np
import open3d
import scipy.linalg
import scipy.ndimage
import scipy.optimize
import scipy.spatial
from scipy.spatial.transform import Rotation

import lat_lon_scanner.scanner as scanner_module

# Depth outside 73-194 mm is the wall, wrapped values or noise, with the
# scanner at the front of its mount slot (rotation center ~120 mm away). With
# it farther back, pass a band that follows it (--depth-range).
default_depth_band_raw = (15000, 40000)

# Drop pixels where exposures disagree by more than ~1 mm.
exposure_disagreement_raw = 200

# A frame is left out of its capture if more than these fractions of its
# pixels are missing from the other frames, or differ from them by more than
# ~0.25 mm (see consistent_frames).
frame_disagreement_raw = 50
frame_unique_fraction_limit = 0.10
frame_disagreement_fraction_limit = 0.15

# The exposure whose left image supplies each point's brightness: long enough
# for the duck's yellow, short enough not to saturate most surfaces.
brightness_exposure = 24000

# Surfaces tilted more than ~75 degrees from facing the camera are dropped,
# and take no color from a color frame whose camera sees them that steeply.
minimum_facing_cosine = 0.25

# A view with fewer points than this is left out: it adds nothing to the fits,
# and normals can't be estimated without neighbors. On 2026-10-28 a white nylon
# part, scanned at exposures that saturate it (12000 and 24000), left three
# views with 0-8 points, and the empty one stopped the reconstruction.
minimum_view_points = 100

default_crop_radius_millimeters = 32.0
default_voxel_millimeters = 0.3

# Saved in each output directory for --reuse-fit.
fit_file_name = "fit.npz"

# A mount found with its top less than this far below the rotation center draws
# a warning; real ones have ended 9-32 mm below it. A round object on the
# turntable axis can pass for the mount: the 2026-11-06 flower pot's 7 mm of
# tapered wall outran the 6 mm post, and it was cut away up to the rotation center.
mount_warning_millimeters = 5.0

# The stage fits stop when a round of Powell's search over all the parameters
# lowers the misalignment by less than this fraction (about 0.001 mm at
# 0.5 mm). At 1e-5, figurine_2's axis fit at 0.8 mm (2026-11-05, 127 views)
# spent 250 evaluations and 30 minutes without lowering it (0.419 -> 0.419 mm).
fit_relative_tolerance = 2e-3

# Neighboring views compared in the stage fits are at most this many times the
# scan plan's spacing apart (and at most 40 degrees, or 70 for the nod fit).
# A dense plan otherwise pairs each view with many more neighbors: figurine_2's
# 15 degree plan had 18 per view within 40 degrees, the bust's 20 degree plan
# 11, and each evaluation of the fit takes time in proportion. With these
# limits (31 and 55 degrees for figurine_2) and fit_relative_tolerance, its
# fit took 18 minutes instead of 115, the merged points came out within
# 0.09 mm (median) of the earlier ones, and the misalignment after refinement
# was the same, 0.347 mm.
neighbor_arc_spacings = 2.1
nod_arc_spacings = 3.7

# Mesh vertices farther than this from every point are trimmed away. Poisson
# closes the opening where the mount was cut away with surface no point
# supports; trimming at 2-3 mm left a lattice of stray triangles around the
# duck's, at 1 mm none. The holes in its beak were still bridged: no part of
# them is more than about 1 mm from a point (a larger hole keeps an opening).
mesh_trim_millimeters = 1.0

# White balance for the scanner's color camera: gains on its linear R, G, B
# (the JPEG's sRGB curve undone) that make the gray patches of a DGK Digital
# Kolor Kard neutral. Measured 2026-10-28 under a lamp, the card where the
# object sits, the scanner at the front of its slot. Scan under a steady lamp:
# in daylight the colors drift as clouds pass, and the projector's light, weak
# next to a lamp, can dominate (the duck's yellow dye fluoresces green in it).
# A full 3x3 color fit to the card's 18 patches did worse than this by eye: the
# camera seems to see near-infrared, reading inks it should tell apart nearly
# alike (navy as brown, green as gray), and the fit bent other hues to match
# (mean CIE76 delta E 19 under the lamp, 17.5 in daylight).
color_white_balance_gains = np.array([0.627, 1.152, 1.894])

# Some runs have far less blue than those gains expect. Under them the mount's
# white nylon reads 0.5-0.6 as much blue as green (the duck, figurine_2), but
# 0.07 on the 2026-11-06 flower pot, for no known reason, which left its light
# tan pot yellow-green and its light purple flowers tan. A run below this ratio
# draws a warning. --white-from-mount then takes the white from the run's own
# mount instead: the post and cap down to this far below the mount's top, of
# which at least this many points must be seen. It isn't the default because
# on the duck and figurine_2 the fixed gains looked better: the mount's white
# paled the duck and turned figurine_2's hair purple.
minimum_mount_blue_ratio = 0.25
mount_white_height_millimeters = 8.0
minimum_mount_white_points = 200

# A run whose camera white balance gains move by more than this fraction of
# their median draws a warning: one balance then can't fit all its frames.
maximum_white_balance_shift = 0.05

# The linear color --white-from-mount brings the mount's median to: red 1.09 and
# blue 0.96 of green, scaled so that red is 0.8. The scale leaves room for
# surfaces facing the lamp, which are brighter than that median. The color was
# picked by eye on the small flower pot's 2026-11-06 rescan, a quarter of the way
# from neutral towards the nylon's color under the card's gains (1.43, 1, 0.85).
# As neutral its light tan pot came out too gray, and further on its flowers and
# leaves drifted from their real light purple and light green.
white_nylon_color = 0.8 * np.array([1.09, 1.0, 0.96]) / 1.09


class Progress(object):
    """
    Progress output for a reconstruction, each line starting with the time
    since it began. report() prints a finished step's result. update() is
    called often during a long step (loading views, the fits): on a terminal
    it keeps one line updated in place; when the output goes to a file, it
    prints a line about every heartbeat_seconds.
    """
    def __init__(self, heartbeat_seconds = 30.0):
        self.start = time.monotonic()
        self.heartbeat_seconds = heartbeat_seconds
        self.on_terminal = sys.stdout.isatty()
        self.last_update = self.start
        self.live_line_shown = False

    def elapsed(self):
        seconds = int(time.monotonic() - self.start)
        return f"{seconds // 60:3d}:{seconds % 60:02d}"

    def report(self, message):
        line = f"[{self.elapsed()}] {message}"
        print(f"\r{line}\033[K" if self.live_line_shown else line, flush = True)
        self.live_line_shown = False
        self.last_update = time.monotonic()

    def update(self, message):
        now = time.monotonic()
        if now - self.last_update < (0.5 if self.on_terminal else self.heartbeat_seconds):
            return
        self.last_update = now
        line = f"[{self.elapsed()}] {message}"
        if self.on_terminal:
            # Kept within the terminal's width, since a wrapped line can't be rewritten in place.
            print(f"\r{line[:shutil.get_terminal_size().columns - 1]}\033[K", end = "", flush = True)
            self.live_line_shown = True
        else:
            print(line, flush = True)

    def tracked(self, cost, label):
        """Wrap a fit's cost function so update() shows its evaluations and best value so far."""
        evaluations, best = 0, np.inf

        def tracked_cost(trial):
            nonlocal evaluations, best
            value = cost(trial)
            evaluations += 1
            best = min(best, value)
            self.update(f"  {label}: {evaluations} evaluations, best {best:.3f} mm")
            return value
        return tracked_cost


def read_rectified_camera_matrix(path):
    """
    Return the rectified camera matrix from a scanner mapparam file. The file
    holds int32 height, width, count, then float32: a 3x3 matrix, cx, cy, fx,
    fy, 5 distortion coefficients, 7 zeros, and inv(K_rectified R_rectified).
    """
    data = pathlib.Path(path).read_bytes()
    floats = np.array(struct.unpack(f"<{(len(data) - 12) // 4}f", data[12:]))
    upper, rotation = scipy.linalg.rq(np.linalg.inv(floats[25:34].reshape(3, 3)))
    signs = np.diag(np.sign(np.diag(upper)))
    camera_matrix = upper @ signs
    return camera_matrix / camera_matrix[2, 2]


def read_color_camera(calibration_directory, frame_width = 1280):
    """
    Return the color camera's calibration from a run's calibration files, or
    None if the run has none: {"matrix": 3x3 for a frame_width wide frame,
    "distortion": k1 k2 p1 p2 k3, "rotation", "translation"}, where rotation
    and translation (mm) take points from the rectified left camera frame
    (where the depth is) into the color camera's. Prgb.bin holds int16 width
    and height, then the 3x3 matrix as float32 for that size (640x400, half
    the color stream's).
    """
    calibration_directory = pathlib.Path(calibration_directory)
    paths = [calibration_directory / name for name in ("Prgb.bin", "Distort.bin", "LC_RT.bin")]
    if not all(path.exists() for path in paths):
        return None
    matrix_data, distortion_data, transform_data = (path.read_bytes() for path in paths)
    width, height, *matrix = struct.unpack("<2h9f", matrix_data)
    matrix = np.array(matrix).reshape(3, 3)
    matrix[:2] *= frame_width / width
    transform = np.array(struct.unpack("<12f", transform_data))
    return {"matrix" : matrix, "distortion" : np.array(struct.unpack("<5f", distortion_data)),
            "rotation" : transform[:9].reshape(3, 3), "translation" : transform[9:]}


def project_to_color_camera(points, color_camera):
    """
    Return the (x, y) pixel of each point (rectified left camera frame, mm) in
    the color frame, with the lens distortion (OpenCV's model), and its depth
    along the color camera's axis.
    """
    in_color = points @ color_camera["rotation"].T + color_camera["translation"]
    x, y = in_color[:, 0] / in_color[:, 2], in_color[:, 1] / in_color[:, 2]
    k1, k2, p1, p2, k3 = color_camera["distortion"]
    radius_squared = x ** 2 + y ** 2
    radial = 1 + k1 * radius_squared + k2 * radius_squared ** 2 + k3 * radius_squared ** 3
    distorted_x = x * radial + 2 * p1 * x * y + p2 * (radius_squared + 2 * x ** 2)
    distorted_y = y * radial + p1 * (radius_squared + 2 * y ** 2) + 2 * p2 * x * y
    homogeneous = np.column_stack([distorted_x, distorted_y, np.ones_like(x)]) @ color_camera["matrix"].T
    return homogeneous[:, :2], in_color[:, 2]


def srgb_to_linear(values):
    """sRGB-encoded values (0-1) to linear light."""
    values = np.asarray(values, float)
    return np.where(values <= 0.04045, values / 12.92, ((values + 0.055) / 1.055) ** 2.4)


def linear_to_srgb(values):
    """Linear light to sRGB-encoded values (0-1), clipped to the 0-1 range."""
    values = np.clip(values, 0, 1)
    return np.where(values <= 0.0031308, 12.92 * values, 1.055 * values ** (1 / 2.4) - 0.055)


def view_colors(points, normals, color_frame, color_camera, spacing_millimeters, occlusion_millimeters = 2.0):
    """
    Return (colors, facing) for surface points (rectified left camera frame,
    mm, with outward normals) from one view's color frame: each point's color
    as linear RGB, not yet white balanced, NaN where the color camera doesn't
    see it, and the cosine of the angle between its normal and the direction to
    the color camera.

    A point is seen if it faces the color camera (facing above
    minimum_facing_cosine) and nothing nearer than occlusion_millimeters lands
    within a bin of it: a depth buffer of the points themselves, in bins about
    spacing_millimeters across, spread to the neighboring bins to close the
    gaps between projected points. The color camera sits 14.7 mm from the
    left one, so it sees around edges differently. The frame is averaged over
    a bin before sampling, to match the points' spacing.
    """
    height, width = color_frame.shape[:2]
    pixels, depth = project_to_color_camera(points, color_camera)
    camera_center = -color_camera["rotation"].T @ color_camera["translation"]
    toward_camera = camera_center - points
    facing = np.sum(normals * toward_camera, axis = 1) / np.linalg.norm(toward_camera, axis = 1)
    inside = ((pixels[:, 0] >= 0) & (pixels[:, 0] < width - 1) & (pixels[:, 1] >= 0) & (pixels[:, 1] < height - 1)
              & (depth > 0))
    colors = np.full((len(points), 3), np.nan)
    if not inside.any():
        return colors, facing
    bin_pixels = max(1, int(np.ceil(color_camera["matrix"][0, 0] * spacing_millimeters / np.median(depth[inside]))))
    bin_rows, bin_columns = -(-height // bin_pixels), -(-width // bin_pixels)
    bins = np.zeros(len(points), int)
    bins[inside] = ((pixels[inside, 1] // bin_pixels).astype(int) * bin_columns
                    + (pixels[inside, 0] // bin_pixels).astype(int))
    nearest = np.full(bin_rows * bin_columns, np.inf)
    np.minimum.at(nearest, bins[inside], depth[inside])
    nearest = scipy.ndimage.minimum_filter(nearest.reshape(bin_rows, bin_columns), size = 3).ravel()
    seen = inside & (facing > minimum_facing_cosine) & (depth <= nearest[bins] + occlusion_millimeters)

    # Bilinear sampling of the frame, in linear light and averaged over a bin, at each seen point.
    frame = scipy.ndimage.uniform_filter(srgb_to_linear(color_frame / 255.0), size = (bin_pixels, bin_pixels, 1))
    x, y = pixels[seen, 0], pixels[seen, 1]
    left, top = np.floor(x).astype(int), np.floor(y).astype(int)
    right_weight, bottom_weight = (x - left)[:, None], (y - top)[:, None]
    sampled = ((frame[top, left] * (1 - right_weight) + frame[top, left + 1] * right_weight) * (1 - bottom_weight)
               + (frame[top + 1, left] * (1 - right_weight) + frame[top + 1, left + 1] * right_weight) * bottom_weight)
    colors[seen] = sampled
    return colors, facing


def photo_colors(points, normals, color_views, progress = None):
    """
    Return (colors, frame_counts): each surface point's linear color, not yet
    white balanced (object frame, mm, with outward normals), from every color
    frame that sees it (see view_colors), averaged with each frame weighted by
    how squarely the point faces its camera, NaN where none does; and how many
    frames saw each point. color_views holds (camera_to_object transform, color
    frame, color camera) for each view with a color frame.

    Averaging over frames removes the projector's stripes, which stay put in
    the frames while the object turns under them. Every frame that sees a
    point counts, not only those of the views that measured it: the duck's
    pink beak gets depth on only 10-33% of its pixels in any one view.
    """
    progress = progress if progress is not None else Progress()
    spacing = float(np.median(scipy.spatial.cKDTree(points).query(points, k = 2)[0][:, 1]))
    sums, weights, frame_counts = np.zeros((len(points), 3)), np.zeros(len(points)), np.zeros(len(points), int)
    for index, (camera_to_object, color_frame, color_camera) in enumerate(color_views):
        progress.update(f"  coloring {len(points)} points: color frame {index + 1}/{len(color_views)}")
        object_to_camera = np.linalg.inv(camera_to_object)
        colors, facing = view_colors(apply_transform(object_to_camera, points), normals @ object_to_camera[:3, :3].T,
                                     color_frame, color_camera, spacing)
        seen = ~np.isnan(colors[:, 0])
        sums[seen] += facing[seen, None] * colors[seen]
        weights[seen] += facing[seen]
        frame_counts[seen] += 1
    colors = np.full((len(points), 3), np.nan)
    colors[weights > 0] = sums[weights > 0] / weights[weights > 0, None]
    return colors, frame_counts


def median_over_frames(stack):
    """
    np.nanmedian(stack, axis = 0) for a short stack of frames: the same result,
    ten times faster. numpy's takes 0.23 s on four 640 x 400 frames (it goes
    through masked arrays), and merging a view's exposures takes 16 of them.
    """
    ordered = np.sort(stack, axis = 0)  # NaN sorts last.
    counts = np.sum(~np.isnan(stack), axis = 0)
    lower = np.take_along_axis(ordered, np.clip((counts - 1) // 2, 0, None)[None], axis = 0)[0]
    upper = np.take_along_axis(ordered, np.clip(counts // 2, 0, len(stack) - 1)[None], axis = 0)[0]
    median = 0.5 * (lower + upper)
    median[counts == 0] = np.nan
    return median


def consistent_frames(frames, depth_band_raw = default_depth_band_raw):
    """
    Return the indices of the depth frames that agree with the rest of their
    capture. The scanner occasionally delivers a frame left over from its
    previous stream as the first frame, which after a stage move shows the
    object at the previous pose; merged in, it leaves curved sheets off the
    surface. Such a frame has many pixels the other frames lack, or that
    disagree with them, where real frames match to a few raw units. On the
    2026-10-27 duck scans the two stale frames scored 48-56% unique pixels
    against at most 1.3% for the other 550 frames. Needs three or more frames;
    with fewer, all are kept.
    """
    depth = frames.astype(float)
    depth[(depth < depth_band_raw[0]) | (depth > depth_band_raw[1])] = np.nan
    if len(depth) < 3:
        return np.arange(len(depth))
    kept = []
    with warnings.catch_warnings():
        warnings.simplefilter("ignore", RuntimeWarning)
        for index in range(len(depth)):
            valid = np.isfinite(depth[index])
            if not valid.any():
                continue
            others = median_over_frames(np.delete(depth, index, axis = 0))
            unique = np.mean(np.isnan(others[valid]))
            overlap = valid & np.isfinite(others)
            disagreeing = (np.mean(np.abs(depth[index][overlap] - others[overlap]) > frame_disagreement_raw)
                           if overlap.any() else 1.0)
            if (unique <= frame_unique_fraction_limit) and (disagreeing <= frame_disagreement_fraction_limit):
                kept.append(index)
    return np.array(kept, dtype = int)


def merge_exposures(view_data, exposures, depth_band_raw = default_depth_band_raw):
    """
    Return one depth map (raw units, NaN where invalid or outside
    depth_band_raw) from all exposures and frames of a view, leaving out frames
    that disagree with the rest of their capture (see consistent_frames).
    """
    per_exposure = []
    with warnings.catch_warnings():
        warnings.simplefilter("ignore", RuntimeWarning)
        for exposure in exposures:
            frames = view_data[f"depth_{exposure}"]
            frames = frames[consistent_frames(frames, depth_band_raw)].astype(float)
            if len(frames) == 0:
                continue
            frames[(frames < depth_band_raw[0]) | (frames > depth_band_raw[1])] = np.nan
            per_exposure.append(median_over_frames(frames))
        if not per_exposure:
            # Nothing in the band at any exposure (e.g. the object is out of range).
            return np.full(view_data[f"depth_{exposures[0]}"].shape[1:], np.nan)
        stack = np.array(per_exposure)
        merged = median_over_frames(stack)
        spread = np.nanmax(stack, axis = 0) - np.nanmin(stack, axis = 0)
    merged[spread > exposure_disagreement_raw] = np.nan
    return merged


def remove_depth_edges(depth, jump_millimeters = 2.0, margin_pixels = 2):
    """
    Return a copy of a raw depth map without the pixels near holes and depth
    jumps. Structured light blends the object and the background at silhouette
    edges, which shows up as thin curved sheets floating off the surface.
    """
    valid = np.isfinite(depth)
    filled = np.where(valid, depth, 0.0)
    jump_raw = jump_millimeters / scanner_module.depth_unit_millimeters
    local_maximum = scipy.ndimage.maximum_filter(np.where(valid, depth, -np.inf), size = 3)
    local_minimum = scipy.ndimage.minimum_filter(np.where(valid, depth, np.inf), size = 3)
    jumps = valid & ((local_maximum - filled > jump_raw) | (filled - local_minimum > jump_raw))
    trusted = scipy.ndimage.binary_erosion(valid & ~jumps, iterations = margin_pixels)
    return np.where(trusted, depth, np.nan)


def depth_to_points(depth, camera_matrix):
    """Return (points in mm, rows, columns) for the valid pixels of a raw depth map."""
    rows, columns = np.nonzero(np.isfinite(depth))
    z = depth[rows, columns] * scanner_module.depth_unit_millimeters
    focal, center_u, center_v = camera_matrix[0, 0], camera_matrix[0, 2], camera_matrix[1, 2]
    points = np.column_stack([(columns - center_u) * z / focal, (rows - center_v) * z / focal, z])
    return points, rows, columns


def axis_from_angles(base, tilt_angles):
    """Unit vector near the axis-aligned unit vector 'base', tilted by two small angles (radians)."""
    first_perpendicular = np.roll(np.abs(base), 1)
    second_perpendicular = np.cross(base, first_perpendicular)
    tilt = Rotation.from_rotvec(tilt_angles[0] * first_perpendicular + tilt_angles[1] * second_perpendicular)
    return tilt.apply(base)


class StageModel(object):
    """
    Where the stage's axes are in the camera frame (x right, y down, z away),
    and how far the object nods as the cradle tilts.

    A point fixed to the object, at p in the object frame (the camera frame at
    latitude 0, longitude 0), appears at

        R_lat(latitude) [N(latitude) [R_lon(longitude) (p - lon_point) + lon_point - pivot] + pivot - lat_point] + lat_point

    The latitude axis is near +x (+latitude tips the top toward the camera) and
    the longitude axis near up, -y (+longitude is counterclockwise from above).
    Parameters: two tilt angles for each axis, the (y, z) of the latitude axis
    where x = reference x, and the (x, z) of the longitude axis where y =
    reference y.

    N(latitude) is the nod: a rotation by nod_gain_degrees * sin(latitude),
    the same way as the latitude, about a line parallel to the latitude axis
    through the pivot, a point on the turntable axis nod_pivot_height mm above
    the rotation center (negative is below). It follows the gravity load as
    the cradle tilts: on 2026-10-27 the bust, held on its cap by a ~0.5 mm gel
    pad 28.5 mm below the rotation center, tipped toward the scanner at high
    latitudes and away at negative ones, 2.5 degrees x sin(latitude) about a
    pivot 8.5 mm below the center. A nod about one pivot plus a slide toward
    the scanner looks like a nod about another, so the pivot can't tell the
    object tipping and sliding on its mount from the cradle yielding.
    """
    latitude_base = np.array([1.0, 0.0, 0.0])
    longitude_base = np.array([0.0, -1.0, 0.0])

    def __init__(self, parameters, reference_point, nod_gain_degrees = 0.0, nod_pivot_height = 0.0):
        self.parameters = np.asarray(parameters, float)
        self.reference_point = np.asarray(reference_point, float)
        self.latitude_axis = axis_from_angles(self.latitude_base, self.parameters[0:2])
        self.longitude_axis = axis_from_angles(self.longitude_base, self.parameters[2:4])
        self.latitude_point = np.array([self.reference_point[0], self.parameters[4], self.parameters[5]])
        self.longitude_point = np.array([self.parameters[6], self.reference_point[1], self.parameters[7]])
        self.nod_gain_degrees = float(nod_gain_degrees)
        self.nod_pivot_height = float(nod_pivot_height)
        self.nod_pivot = self.closest_points()[1] + self.nod_pivot_height * self.longitude_axis

    def camera_to_object(self, latitude, longitude):
        """Return the 4x4 transform taking camera-frame points of a view into the object frame."""
        latitude_rotation = Rotation.from_rotvec(np.radians(latitude) * self.latitude_axis).inv().as_matrix()
        longitude_rotation = Rotation.from_rotvec(np.radians(longitude) * self.longitude_axis).inv().as_matrix()
        nod_degrees = self.nod_gain_degrees * np.sin(np.radians(latitude))
        nod_rotation = Rotation.from_rotvec(np.radians(nod_degrees) * self.latitude_axis).inv().as_matrix()
        rotation = longitude_rotation @ nod_rotation @ latitude_rotation
        translation = (longitude_rotation @ (nod_rotation @ (self.latitude_point - latitude_rotation @ self.latitude_point
                                                             - self.nod_pivot) + self.nod_pivot - self.longitude_point)
                       + self.longitude_point)
        transform = np.eye(4)
        transform[:3, :3] = rotation
        transform[:3, 3] = translation
        return transform

    def closest_points(self):
        """Return the points where the latitude and longitude axes come closest, on each."""
        normal = np.cross(self.latitude_axis, self.longitude_axis)
        matrix = np.column_stack([self.latitude_axis, -self.longitude_axis, normal])
        along_latitude, along_longitude, _ = np.linalg.solve(matrix, self.longitude_point - self.latitude_point)
        return (self.latitude_point + along_latitude * self.latitude_axis,
                self.longitude_point + along_longitude * self.longitude_axis)

    def rotation_center(self):
        """Return (the midpoint of the axes' closest approach, the gap between them in mm)."""
        on_latitude, on_longitude = self.closest_points()
        return 0.5 * (on_latitude + on_longitude), float(np.linalg.norm(on_latitude - on_longitude))


def apply_transform(transform, points):
    return points @ transform[:3, :3].T + transform[:3, 3]


def view_direction(latitude, longitude):
    """Unit vector for a view on the sphere of stage angles, for measuring how far apart views are."""
    latitude, longitude = np.radians(latitude), np.radians(longitude)
    return np.array([np.cos(latitude) * np.cos(longitude), np.cos(latitude) * np.sin(longitude), np.sin(latitude)])


def neighbor_pairs(poses, maximum_arc_degrees = 40.0):
    directions = np.array([view_direction(*pose) for pose in poses])
    arcs = np.degrees(np.arccos(np.clip(directions @ directions.T, -1, 1)))
    return [(i, j) for i in range(len(poses)) for j in range(len(poses)) if i != j and arcs[i, j] <= maximum_arc_degrees]


def plan_spacing_degrees(poses):
    """The median arc from each view to its nearest neighbor."""
    directions = np.array([view_direction(*pose) for pose in poses])
    arcs = np.degrees(np.arccos(np.clip(directions @ directions.T, -1, 1)))
    np.fill_diagonal(arcs, np.inf)
    return float(np.median(arcs.min(axis = 1)))


def nearest_upright_view(poses):
    """
    Index of the view nearest latitude 0, longitude 0 (the first one if several
    are equally near). Scan plans without a latitude 0 row, such as the 20
    degree plan's 10 and -10 rows, have no view at exactly (0, 0).
    """
    upright = view_direction(0.0, 0.0)
    return int(np.argmax([view_direction(*pose) @ upright for pose in poses]))


def downsample(points, voxel_size):
    cloud = open3d.geometry.PointCloud(open3d.utility.Vector3dVector(points))
    return np.asarray(cloud.voxel_down_sample(voxel_size).points)


def usable_cores():
    """The cores this process may run on (taskset can restrict them)."""
    return len(os.sched_getaffinity(0)) if hasattr(os, "sched_getaffinity") else os.cpu_count()


def trimmed_mean(distances, keep_fraction):
    """The mean of the smallest keep_fraction of the distances."""
    keep = max(1, int(keep_fraction * len(distances)))
    return float(np.mean(np.partition(distances, keep - 1)[:keep]))


def misalignment(object_clouds, pairs, keep_fraction, cap_millimeters = 5.0):
    """Mean over neighbor pairs of the trimmed mean nearest-neighbor distance (mm)."""
    trees = [scipy.spatial.cKDTree(cloud) for cloud in object_clouds]
    costs = []
    for i, j in pairs:
        distances, _ = trees[j].query(object_clouds[i], distance_upper_bound = cap_millimeters, workers = usable_cores())
        costs.append(trimmed_mean(np.minimum(distances, cap_millimeters), keep_fraction))
    return float(np.mean(costs))


class ViewMisalignment(object):
    """
    misalignment() for views placed by trial stage models, which the fits
    evaluate hundreds of times. Each view's k-d tree is built once, in its own
    camera frame, and a trial moves its neighbors' points into that frame
    instead of rebuilding the trees. Each view's neighbors are queried
    together, spread over the usable cores.
    """
    def __init__(self, camera_clouds, pairs):
        self.camera_clouds = camera_clouds
        self.trees = [scipy.spatial.cKDTree(cloud) for cloud in camera_clouds]
        self.neighbors = {}
        for i, j in pairs:
            self.neighbors.setdefault(j, []).append(i)

    def __call__(self, transforms, keep_fraction, cap_millimeters = 5.0):
        """Misalignment (mm) with each view moved into the object frame by its transform."""
        costs = []
        for j, neighbors in self.neighbors.items():
            object_to_view = np.linalg.inv(transforms[j])
            moved = [apply_transform(object_to_view @ transforms[i], self.camera_clouds[i]) for i in neighbors]
            distances, _ = self.trees[j].query(np.concatenate(moved), distance_upper_bound = cap_millimeters,
                                               workers = usable_cores())
            distances = np.minimum(distances, cap_millimeters)
            for pair_distances in np.split(distances, np.cumsum([len(points) for points in moved])[:-1]):
                costs.append(trimmed_mean(pair_distances, keep_fraction))
        return float(np.mean(costs))


def estimate_center(upright_points):
    """
    Rough rotation center from the view at (or nearest) latitude 0, longitude
    0: the largest cluster's middle, pushed back by half its width since only
    its front is seen.
    """
    cloud = open3d.geometry.PointCloud(open3d.utility.Vector3dVector(upright_points)).voxel_down_sample(0.7)
    labels = np.array(cloud.cluster_dbscan(eps = 2.0, min_points = 10))
    largest = np.asarray(cloud.points)[labels == np.argmax(np.bincount(labels[labels >= 0]))]
    width = np.percentile(largest[:, 0], 98) - np.percentile(largest[:, 0], 2)
    return np.array([np.median(largest[:, 0]), np.median(largest[:, 1]), np.percentile(largest[:, 2], 2) + width / 2])


def fit_stage_model(view_points, poses, center_guess, crop_radius, progress = None):
    """
    Fit the StageModel: the axes by minimizing the misalignment between
    neighboring views, then the nod with views farther apart compared as well,
    then the axes again with that nod.

    One latitude row's nod barely differs from the next row's, but across
    several rows it adds up (1-2 mm between the bust's -20 and +50 rows), so
    the nod is fitted on views up to nod_arc_degrees apart, scored on the
    closest nod_keep_fraction of each pair's points since far-apart views
    overlap less. On the bust, this score fell 11% for the nod against 6% for
    the neighbors-only one.
    """
    nod_keep_fraction = 0.4
    progress = progress if progress is not None else Progress()
    spacing = plan_spacing_degrees(poses)
    pairs = neighbor_pairs(poses, min(40.0, neighbor_arc_spacings * spacing))
    nod_arc_degrees = min(70.0, nod_arc_spacings * spacing)
    parameters = np.array([0, 0, 0, 0, center_guess[1], center_guess[2], center_guess[0], center_guess[2]], float)
    nod = np.zeros(2)

    def transforms(trial_parameters, trial_nod):
        model = StageModel(trial_parameters, center_guess, *trial_nod)
        return [model.camera_to_object(*pose) for pose in poses]

    def fit_axes(view_misalignment, keep_fraction, label):
        cost = lambda trial_parameters: view_misalignment(transforms(trial_parameters, nod), keep_fraction)
        start_cost = cost(parameters)
        result = scipy.optimize.minimize(progress.tracked(cost, label), parameters, method = "Powell",
                                         options = {"xtol" : 1e-3, "ftol" : fit_relative_tolerance, "maxfev" : 4000})
        progress.report(f"  {label}: misalignment {start_cost:.3f} -> {result.fun:.3f} mm")
        return result.x, float(result.fun)

    for voxel_size, keep_fraction in [(1.5, 0.5), (0.8, 0.6)]:
        clouds = [downsample(points[np.linalg.norm(points - center_guess, axis = 1) < crop_radius], voxel_size)
                  for points in view_points]
        axes_misalignment = ViewMisalignment(clouds, pairs)
        parameters, fit_misalignment = fit_axes(axes_misalignment, keep_fraction, f"axes fit at {voxel_size} mm")

    # The pivot starts halfway down the crop sphere, near where the mount usually is.
    nod_misalignment = ViewMisalignment(clouds, neighbor_pairs(poses, nod_arc_degrees))
    nod_cost = lambda trial_nod: nod_misalignment(transforms(parameters, trial_nod), nod_keep_fraction)
    start_cost = nod_cost(nod)
    result = scipy.optimize.minimize(progress.tracked(nod_cost, "nod fit"), [0.0, -0.5 * crop_radius], method = "Powell",
                                     bounds = [(-10.0, 10.0), (-crop_radius, crop_radius)],
                                     options = {"xtol" : 1e-2, "ftol" : fit_relative_tolerance, "maxfev" : 300})
    nod = result.x
    progress.report(f"  nod fit on views up to {nod_arc_degrees:.0f} degrees apart: misalignment {start_cost:.3f} -> "
                    f"{result.fun:.3f} mm, nod {nod[0]:+.2f} degrees x sin(latitude) about a pivot {nod[1]:+.1f} mm "
                    f"along the turntable axis from the rotation center")
    parameters, fit_misalignment = fit_axes(axes_misalignment, keep_fraction, "axes refit with the nod")
    return StageModel(parameters, center_guess, *nod), fit_misalignment


def refine_poses(object_clouds, poses, voxel_size = 0.8, maximum_distance = 1.0, progress = None):
    """
    Joint (multiway) ICP over neighboring views. Returns a small correction
    transform for each view, applied after the stage model.

    The corrections are anchored so that on average they leave the object where
    the stage model put it, keeping the mount on the fitted turntable axis for
    remove_mount. Pinning one view instead moves everything with that view's
    own error: on the 2026-10-27 bust, pinning the +90 view shifted the rest
    about 2 mm and the mount was no longer found.
    """
    clouds = []
    for points in object_clouds:
        cloud = open3d.geometry.PointCloud(open3d.utility.Vector3dVector(points)).voxel_down_sample(voxel_size)
        cloud.estimate_normals(open3d.geometry.KDTreeSearchParamHybrid(radius = 3 * voxel_size, max_nn = 30))
        clouds.append(cloud)
    pose_graph = open3d.pipelines.registration.PoseGraph()
    for _ in clouds:
        pose_graph.nodes.append(open3d.pipelines.registration.PoseGraphNode(np.eye(4)))
    estimation = open3d.pipelines.registration.TransformationEstimationPointToPlane()
    progress = progress if progress is not None else Progress()
    pairs = [(i, j) for i, j in neighbor_pairs(poses) if i < j]
    for pair_index, (i, j) in enumerate(pairs):
        progress.update(f"  joint refinement: aligning neighboring views, pair {pair_index + 1}/{len(pairs)}")
        result = open3d.pipelines.registration.registration_icp(clouds[i], clouds[j], maximum_distance, np.eye(4), estimation)
        information = open3d.pipelines.registration.get_information_matrix_from_point_clouds(
            clouds[i], clouds[j], maximum_distance, result.transformation)
        pose_graph.edges.append(open3d.pipelines.registration.PoseGraphEdge(
            i, j, result.transformation, information, uncertain = True))
    option = open3d.pipelines.registration.GlobalOptimizationOption(
        max_correspondence_distance = maximum_distance, edge_prune_threshold = 0.25, reference_node = 0)
    with open3d.utility.VerbosityContextManager(open3d.utility.VerbosityLevel.Error):
        open3d.pipelines.registration.global_optimization(
            pose_graph, open3d.pipelines.registration.GlobalOptimizationLevenbergMarquardt(),
            open3d.pipelines.registration.GlobalOptimizationConvergenceCriteria(), option)
    corrections = [np.array(node.pose) for node in pose_graph.nodes]
    average = np.eye(4)
    average[:3, :3] = Rotation.from_matrix([correction[:3, :3] for correction in corrections]).mean().as_matrix()
    average[:3, 3] = np.mean([correction[:3, 3] for correction in corrections], axis = 0)
    return [np.linalg.inv(average) @ correction for correction in corrections]


def remove_mount(points, axis_point, up, slice_millimeters = 0.5, mount_top = None):
    """
    Return (mask keeping the object, mount top height, mount radius) to drop
    the post and cap the object sits on. axis_point is the point on the
    turntable axis level with the rotation center; heights are measured from it
    along up. With mount_top given, the mount isn't searched for: everything
    above that height is kept.

    The mount is a stack of cylinders on the turntable axis, and a slice through
    a cylinder wall puts every point at nearly the same distance from the axis,
    unlike a slice through the object. The post is the longest unbroken run of
    cylinder-like slices below the rotation center; from its top the walk up
    continues through cylinder-like slices (tolerating short transitions such
    as a step from post to cap) and the object starts where they stop.
    Everything well below that is dropped, and just above it anything inside
    the mount's radius.
    """
    height = (points - axis_point) @ up
    radial = np.linalg.norm((points - axis_point) - np.outer(height, up), axis = 1)
    if mount_top is not None:
        below_top = (height >= mount_top - slice_millimeters) & (height < mount_top)
        mount_radius = float(np.percentile(radial[below_top], 90)) + 0.5 if below_top.any() else 0.0
        return height >= mount_top, mount_top, mount_radius
    slice_bottoms = np.arange(np.floor(height.min()), 0.0, slice_millimeters)
    spreads, outer_radii = [], []
    for bottom in slice_bottoms:
        in_slice = (height >= bottom) & (height < bottom + slice_millimeters)
        if in_slice.sum() < 30:
            spreads.append(np.inf)
            outer_radii.append(np.inf)
            continue
        low, high = np.percentile(radial[in_slice], [10, 90])
        spreads.append(high - low)
        outer_radii.append(high)
    spreads, outer_radii = np.array(spreads), np.array(outer_radii)
    cylinder_like = spreads < 1.0

    # Longest run of consecutive cylinder-like slices: the post.
    post_start, post_length, run_start = 0, 0, None
    for index, is_cylinder in enumerate(list(cylinder_like) + [False]):
        if is_cylinder and run_start is None:
            run_start = index
        elif not is_cylinder and run_start is not None:
            if index - run_start > post_length:
                post_start, post_length = run_start, index - run_start
            run_start = None
    if post_length == 0:
        raise RuntimeError("No cylinder-like mount found below the rotation center")

    index = post_start + post_length - 1
    last_cylinder_index = index
    misses = 0
    while index + 1 < len(slice_bottoms) and misses < 3:
        index += 1
        if cylinder_like[index]:
            last_cylinder_index = index
            misses = 0
        else:
            misses += 1
    walked = slice(post_start, last_cylinder_index + 1)
    mount_radius = float(np.max(outer_radii[walked][cylinder_like[walked]])) + 0.5
    mount_top = float(slice_bottoms[last_cylinder_index] + slice_millimeters)
    keep = (height >= mount_top - 1.0) & ~((height < mount_top + 1.5) & (radial < mount_radius))
    return keep, mount_top, mount_radius


def mount_warning(mount_top):
    """A warning if the mount found ends suspiciously near the rotation center, otherwise None."""
    if mount_top < -mount_warning_millimeters:
        return None
    return (f"  warning: the mount's top is only {abs(mount_top):.1f} mm from the rotation center. A round object on the "
            f"turntable axis can pass for the mount; if the object lost its lower part, set --mount-top.")


def mount_white_points(points, normals, axis_point, up, mount_top, mount_radius, voxel_size = 0.5):
    """Return (points, normals) of the post and cap just below the object, thinned to voxel_size."""
    height = (points - axis_point) @ up
    radial = np.linalg.norm((points - axis_point) - np.outer(height, up), axis = 1)
    near_top = (height >= mount_top - mount_white_height_millimeters) & (height < mount_top) & (radial < mount_radius)
    cloud = open3d.geometry.PointCloud(open3d.utility.Vector3dVector(points[near_top]))
    cloud.normals = open3d.utility.Vector3dVector(normals[near_top])
    cloud = cloud.voxel_down_sample(voxel_size)
    thinned_normals = np.asarray(cloud.normals)
    return np.asarray(cloud.points), thinned_normals / np.linalg.norm(thinned_normals, axis = 1, keepdims = True)


def mount_median_color(mount_colors):
    """The median of the mount's linear colors (NaN where unseen), or None if too few are seen."""
    seen = ~np.isnan(mount_colors[:, 0])
    if seen.sum() < minimum_mount_white_points:
        return None
    return np.median(mount_colors[seen], axis = 0)


def low_blue_warning(mount_color):
    """A warning if the fixed gains would leave the mount with far too little blue, otherwise None."""
    balanced = mount_color * color_white_balance_gains
    blue_ratio = balanced[2] / balanced[1]
    if blue_ratio >= minimum_mount_blue_ratio:
        return None
    return (f"  warning: the color frames have unusually little blue (the mount reads {blue_ratio:.2f} as much blue as "
            f"green, normally 0.5-0.6). If the colors look too yellow, set --white-from-mount.")


def run_white_balance_gains(run_directory):
    """Return the camera's red, green and blue gains for each view that recorded them, as an (n, 3) array."""
    gains = []
    for path in sorted(pathlib.Path(run_directory).glob("view_*.npz")):
        with np.load(path) as view_data:
            if "white_balance_gains" in view_data.files:
                gains.append(view_data["white_balance_gains"])
    return np.array(gains, dtype = float).reshape(-1, 3)


def white_balance_shift_warning(gains):
    """A warning if the gains of a run's views moved too far, otherwise None."""
    shift = (gains.max(axis = 0) - gains.min(axis = 0)) / np.median(gains, axis = 0)
    if shift.max() <= maximum_white_balance_shift:
        return None
    return (f"  warning: the camera's white balance moved during the run (red, green, blue by {(100 * shift).round(1)}%), "
            f"so one balance doesn't fit all its color frames.")


def keep_largest_cluster(cloud, neighbor_distance):
    """Drop everything not connected (within neighbor_distance) to the largest piece."""
    labels = np.array(cloud.cluster_dbscan(eps = neighbor_distance, min_points = 5))
    largest = np.argmax(np.bincount(labels[labels >= 0]))
    return cloud.select_by_index(np.nonzero(labels == largest)[0])


def build_mesh(cloud, voxel_size, trim_millimeters = mesh_trim_millimeters):
    """
    Return (mesh, octree depth): a triangle mesh fitted to the cloud (points
    with outward normals) by Poisson surface reconstruction, which bridges the
    small holes the scan left, such as on the duck's beak. The octree's cells
    are about voxel_size across: with half that, the voxel grid the points sit
    on showed through as ripples on the duck. Vertices farther than
    trim_millimeters from every point are dropped (see mesh_trim_millimeters),
    and so is anything left disconnected from the largest piece.
    """
    points = np.asarray(cloud.points)
    extent = (points.max(axis = 0) - points.min(axis = 0)).max()
    scale = 1.1    # Open3D's default: the octree spans the points' extent x 1.1
    octree_depth = int(np.round(np.log2(scale * extent / voxel_size)))
    with open3d.utility.VerbosityContextManager(open3d.utility.VerbosityLevel.Error):
        mesh, _ = open3d.geometry.TriangleMesh.create_from_point_cloud_poisson(cloud, depth = octree_depth, scale = scale)
    distances, _ = scipy.spatial.cKDTree(points).query(np.asarray(mesh.vertices))
    mesh.remove_vertices_by_mask(distances > trim_millimeters)
    clusters, cluster_sizes, _ = mesh.cluster_connected_triangles()
    mesh.remove_triangles_by_mask(np.asarray(clusters) != np.argmax(cluster_sizes))
    mesh.remove_unreferenced_vertices()
    mesh.compute_vertex_normals()
    return mesh, octree_depth


def render_preview(points, normals, colors, eye_direction, up_hint, image_size = 600, point_millimeters = 0.3,
                   light_direction = None):
    """
    Orthographic rendering: each point is splatted as a square about
    point_millimeters across (so neighboring points leave no gaps), nearest
    point wins, shaded by its normal. Returns an (image_size, image_size, 3) uint8 image.
    """
    eye_direction = eye_direction / np.linalg.norm(eye_direction)
    right = np.cross(up_hint, eye_direction)
    right /= np.linalg.norm(right)
    up = np.cross(eye_direction, right)
    centered = points - points.mean(axis = 0)
    horizontal, vertical, toward_eye = centered @ right, centered @ up, centered @ eye_direction
    extent = 1.1 * max(np.abs(horizontal).max(), np.abs(vertical).max())
    columns = ((horizontal / extent + 1) * 0.5 * (image_size - 1)).astype(int)
    rows = ((1 - (vertical / extent + 1) * 0.5) * (image_size - 1)).astype(int)
    if light_direction is None:
        light_direction = eye_direction + 0.5 * up + 0.3 * right
    light_direction = light_direction / np.linalg.norm(light_direction)
    shade = 0.25 + 0.75 * np.clip(normals @ light_direction, 0, 1)
    shaded = np.clip(colors * shade[:, None], 0, 1)

    image = np.full((image_size, image_size, 3), 1.0)
    depth_buffer = np.full((image_size, image_size), -np.inf)
    order = np.argsort(toward_eye)    # far to near, so nearer points overwrite
    millimeters_per_pixel = 2 * extent / (image_size - 1)
    splat_pixels = max(2, int(np.ceil(1.5 * point_millimeters / millimeters_per_pixel)))
    offsets = range(-(splat_pixels // 2), splat_pixels - splat_pixels // 2)
    for row_offset in offsets:
        for column_offset in offsets:
            splat_rows = np.clip(rows[order] + row_offset, 0, image_size - 1)
            splat_columns = np.clip(columns[order] + column_offset, 0, image_size - 1)
            nearer = toward_eye[order] > depth_buffer[splat_rows, splat_columns]
            image[splat_rows[nearer], splat_columns[nearer]] = shaded[order][nearer]
            depth_buffer[splat_rows[nearer], splat_columns[nearer]] = toward_eye[order][nearer]
    return (255 * image).astype(np.uint8)


def load_run_views(run_directory, depth_band_raw = default_depth_band_raw, progress = None):
    """
    Return (poses, points, normals, brightness, color frames) for each view of
    a run, in the camera frame, with edge pixels and edge-on surfaces already
    dropped. A view's color frame is (frame, color camera calibration), or
    None if the run has no color frames. Views with fewer than
    minimum_view_points points are left out, with a warning.
    """
    progress = progress if progress is not None else Progress()
    run_directory = pathlib.Path(run_directory)
    information = json.loads((run_directory / "run.json").read_text())
    all_poses = [tuple(pose) for pose in information["poses"]]
    camera_matrix = read_rectified_camera_matrix(run_directory / "calibration" / "mapparamL.bin")
    color_camera = read_color_camera(run_directory / "calibration")
    # Brightness comes from brightness_exposure, or the nearest exposure the run has.
    exposure_for_brightness = min(information["exposures"], key = lambda exposure: abs(exposure - brightness_exposure))

    poses, view_points, view_normals, view_brightness, view_color_frames = [], [], [], [], []
    for view_index, pose in enumerate(all_poses):
        progress.update(f"loading {run_directory.name}: view {view_index + 1}/{len(all_poses)}")
        view_data = np.load(run_directory / f"view_{view_index:03d}.npz")
        depth = remove_depth_edges(merge_exposures(view_data, information["exposures"], depth_band_raw))
        points, rows, columns = depth_to_points(depth, camera_matrix)
        if len(points) < minimum_view_points:
            progress.report(f"  view {view_index} at {pose} left out: only {len(points)} points "
                            f"(over- or underexposed? see the exposures)")
            continue
        poses.append(pose)
        # Normals in the camera frame, facing the camera that saw them.
        cloud = open3d.geometry.PointCloud(open3d.utility.Vector3dVector(points))
        cloud.estimate_normals(open3d.geometry.KDTreeSearchParamHybrid(radius = 1.0, max_nn = 30))
        cloud.orient_normals_towards_camera_location(np.zeros(3))
        normals = np.asarray(cloud.normals)
        # Drop surfaces seen nearly edge-on, where the depth is least reliable.
        facing = np.sum(normals * -points, axis = 1) / np.linalg.norm(points, axis = 1) > minimum_facing_cosine
        view_points.append(points[facing])
        view_normals.append(normals[facing])
        view_brightness.append(view_data[f"mono_{exposure_for_brightness}"][:400][rows[facing], columns[facing]] / 255.0)
        if color_camera is not None and "color" in view_data.files:
            view_color_frames.append((view_data["color"], color_camera))
        else:
            view_color_frames.append(None)
    if not poses:
        raise RuntimeError(f"No view of {run_directory} has {minimum_view_points} or more points; check the exposures")
    return poses, view_points, view_normals, view_brightness, view_color_frames


def fit_views(view_points, poses, crop_radius, refine, progress):
    """
    Fit the stage and refine each view's pose. Returns (stage model, each
    view's camera to object transform, the fit's misalignment, the misalignment
    before refinement, and after it).
    """
    upright_index = nearest_upright_view(poses)
    center_guess = estimate_center(view_points[upright_index])
    progress.report(f"  first rotation center guess from the view at {poses[upright_index]}")
    model, fit_misalignment = fit_stage_model(view_points, poses, center_guess, crop_radius, progress)
    center, _ = model.rotation_center()
    transforms = [model.camera_to_object(*pose) for pose in poses]
    object_clouds = [apply_transform(transform, points[np.linalg.norm(points - center, axis = 1) < crop_radius])
                     for transform, points in zip(transforms, view_points)]
    pairs = neighbor_pairs(poses)
    before = misalignment([downsample(cloud, 0.8) for cloud in object_clouds], pairs, 0.6)
    if not refine:
        return model, transforms, fit_misalignment, before, before
    corrections = refine_poses(object_clouds, poses, progress = progress)
    transforms = [correction @ transform for correction, transform in zip(corrections, transforms)]
    object_clouds = [apply_transform(correction, cloud) for correction, cloud in zip(corrections, object_clouds)]
    after = misalignment([downsample(cloud, 0.8) for cloud in object_clouds], pairs, 0.6)
    progress.report(f"  joint refinement: misalignment {before:.3f} -> {after:.3f} mm")
    return model, transforms, fit_misalignment, before, after


def save_fit(path, model, poses, transforms, fit_misalignment, before, after):
    """Save what fit_views returned, so that a later reconstruction can skip it (see load_fit)."""
    np.savez(path, parameters = model.parameters, reference_point = model.reference_point,
             nod = np.array([model.nod_gain_degrees, model.nod_pivot_height]), poses = np.array(poses),
             transforms = np.array(transforms), misalignments = np.array([fit_misalignment, before, after]))


def load_fit(path, poses):
    """Return what save_fit saved at path, in the form fit_views returns it, for the views at poses."""
    if not path.exists():
        raise RuntimeError(f"{path} doesn't exist: that output has no saved fit to reuse")
    with np.load(path) as fit:
        if fit["poses"].shape != np.shape(poses) or not np.allclose(fit["poses"], poses):
            raise RuntimeError(f"{path} has different views from this run (a view left out at another depth range?)")
        model = StageModel(fit["parameters"], fit["reference_point"], *fit["nod"])
        return (model, list(fit["transforms"]), *fit["misalignments"].tolist())


def reconstruct(run_directory, crop_radius = default_crop_radius_millimeters, voxel_size = default_voxel_millimeters,
                refine = True, extra_runs = (), output_name = "reconstruction", depth_band_raw = default_depth_band_raw,
                make_mesh = True, mount_top = None, white_from_mount = False, reuse_fit = None):
    """
    Reconstruct the object from run_directory. The stage axes are fitted from
    that run alone; views from extra_runs (taken without moving the scanner or
    re-zeroing the stage) are placed with the same axes and merged in.
    mount_top is passed on to remove_mount. With white_from_mount, the color
    frames are white balanced from the mount rather than the fixed gains.
    reuse_fit names an earlier output directory of this run, whose stage fit
    and view poses are used instead of fitting them again.
    """
    run_directory = pathlib.Path(run_directory)
    output_directory = run_directory / output_name
    output_directory.mkdir(exist_ok = True)
    camera_matrix = read_rectified_camera_matrix(run_directory / "calibration" / "mapparamL.bin")

    progress = Progress()
    poses, view_points, view_normals, view_brightness, view_color_frames = load_run_views(run_directory, depth_band_raw,
                                                                                          progress)
    progress.report(f"{len(poses)} views loaded, {sum(len(p) for p in view_points)} points")

    if reuse_fit is None:
        model, transforms, fit_misalignment, before, after = fit_views(view_points, poses, crop_radius, refine, progress)
    else:
        model, transforms, fit_misalignment, before, after = load_fit(run_directory / reuse_fit / fit_file_name, poses)
        progress.report(f"  stage fit and view poses reused from {reuse_fit}")
    save_fit(output_directory / fit_file_name, model, poses, transforms, fit_misalignment, before, after)
    center, axis_gap = model.rotation_center()
    progress.report(f"  rotation center {center.round(2)} mm, axes {axis_gap:.2f} mm apart")

    near_center = [np.linalg.norm(points - center, axis = 1) < crop_radius for points in view_points]
    object_clouds = [apply_transform(transform, points[mask]) for transform, points, mask in zip(transforms, view_points, near_center)]

    for extra_run in extra_runs:
        extra_poses, extra_points, extra_normals, extra_brightness, extra_color_frames = load_run_views(
            extra_run, depth_band_raw, progress)
        extra_transforms = [model.camera_to_object(*pose) for pose in extra_poses]
        extra_near = [np.linalg.norm(points - center, axis = 1) < crop_radius for points in extra_points]
        object_clouds += [apply_transform(transform, points[mask])
                          for transform, points, mask in zip(extra_transforms, extra_points, extra_near)]
        transforms += extra_transforms
        near_center += extra_near
        view_normals += extra_normals
        view_brightness += extra_brightness
        view_color_frames += extra_color_frames
        progress.report(f"  added {len(extra_poses)} views from {extra_run}")

    points = np.concatenate(object_clouds)
    normals = np.concatenate([normals[mask] @ transform[:3, :3].T
                              for normals, mask, transform in zip(view_normals, near_center, transforms)])
    brightness = np.concatenate([values[mask] for values, mask in zip(view_brightness, near_center)])
    color_views = [(transform, *color_frame) for transform, color_frame in zip(transforms, view_color_frames)
                   if color_frame is not None]
    # Measure the mount from the turntable axis, not the rotation center: the
    # center sits midway between the axes, so it is off the turntable axis by
    # half their gap (0.79 mm for the 2026-10-27 bust), enough to make the post
    # look out of round.
    up = model.longitude_axis
    axis_point = model.longitude_point + ((center - model.longitude_point) @ up) * up
    mount_was_found = mount_top is None
    keep, mount_top, mount_radius = remove_mount(points, axis_point, up, mount_top = mount_top)
    progress.report(f"  mount cut away: top {mount_top:.1f} mm along the turntable axis from the rotation center, "
                    f"radius {mount_radius:.1f} mm")
    warning = mount_warning(mount_top) if mount_was_found else None
    if warning is not None:
        progress.report(warning)
    white_points, white_normals = mount_white_points(points, normals, axis_point, up, mount_top, mount_radius)

    cloud = open3d.geometry.PointCloud(open3d.utility.Vector3dVector(points[keep]))
    cloud.normals = open3d.utility.Vector3dVector(normals[keep])
    cloud.colors = open3d.utility.Vector3dVector(np.repeat(brightness[keep][:, None], 3, axis = 1))
    cloud = cloud.voxel_down_sample(voxel_size)
    cloud, _ = cloud.remove_statistical_outlier(nb_neighbors = 20, std_ratio = 2.0)
    before_cluster = len(cloud.points)
    cloud = keep_largest_cluster(cloud, 3 * voxel_size)
    progress.report(f"  kept the largest connected piece: {len(cloud.points)} of {before_cluster} points")
    normals = np.asarray(cloud.normals)
    cloud.normals = open3d.utility.Vector3dVector(normals / np.linalg.norm(normals, axis = 1, keepdims = True))
    final_points, final_normals = np.asarray(cloud.points), np.asarray(cloud.normals)
    final_brightness = np.asarray(cloud.colors)[:, 0].copy()
    color_record = None
    if color_views:
        # Colors from the frames that see each point, gray where none does. The mount's points go
        # in with the object's so that the object hides them where it should. The fixed gains are
        # scaled so the brightest 1% reach white (they were fitted under a different light).
        all_colors, all_frame_counts = photo_colors(np.concatenate([final_points, white_points]),
                                                    np.concatenate([final_normals, white_normals]), color_views, progress)
        point_colors, frame_counts = all_colors[:len(final_points)], all_frame_counts[:len(final_points)]
        colored = ~np.isnan(point_colors[:, 0])
        mount_color = mount_median_color(all_colors[len(final_points):])
        if white_from_mount and mount_color is not None:
            color_gains, white_source = white_nylon_color / mount_color, "the mount"
        else:
            balanced = point_colors[colored] * color_white_balance_gains
            color_gains = color_white_balance_gains / np.percentile(balanced.max(axis = 1), 99)
            white_source = "the fixed gains"
        progress.report(f"  white balance from {white_source}: gains {color_gains.round(2)}")
        warning = low_blue_warning(mount_color) if mount_color is not None and not white_from_mount else None
        if warning is not None:
            progress.report(warning)
        final_colors = np.full((len(final_points), 3), 0.5)
        final_colors[colored] = linear_to_srgb(point_colors[colored] * color_gains)
        cloud.colors = open3d.utility.Vector3dVector(final_colors)
        color_record = {"color_frames" : len(color_views), "colored_fraction" : float(colored.mean()),
                        "median_frames_per_point" : float(np.median(frame_counts[colored])),
                        "white_source" : white_source, "gains" : color_gains.tolist()}
        camera_gains = run_white_balance_gains(run_directory)
        if len(camera_gains) > 0:
            color_record["camera_white_balance"] = {"median" : np.median(camera_gains, axis = 0).tolist(),
                                                    "minimum" : camera_gains.min(axis = 0).tolist(),
                                                    "maximum" : camera_gains.max(axis = 0).tolist()}
            progress.report(f"  camera white balance over {len(camera_gains)} views: median "
                            f"{np.median(camera_gains, axis = 0).round(2)}, from {camera_gains.min(axis = 0).round(2)} "
                            f"to {camera_gains.max(axis = 0).round(2)}")
            warning = white_balance_shift_warning(camera_gains)
            if warning is not None:
                progress.report(warning)
        progress.report(f"  colored {colored.mean():.1%} of the points from {len(color_views)} color frames, "
                        f"a median of {color_record['median_frames_per_point']:.0f} per point")
    open3d.io.write_point_cloud(str(output_directory / "point_cloud.ply"), cloud)
    extent = final_points.max(axis = 0) - final_points.min(axis = 0)
    progress.report(f"  {len(final_points)} points written, extent {extent.round(1)} mm")

    mesh_record = None
    if make_mesh:
        mesh, octree_depth = build_mesh(cloud, voxel_size)
        vertices, vertex_normals = np.asarray(mesh.vertices), np.asarray(mesh.vertex_normals)
        # A vertex no frame sees, or any vertex in a run without color, takes the nearest point's color.
        _, nearest = scipy.spatial.cKDTree(final_points).query(vertices)
        vertex_colors = np.asarray(cloud.colors)[nearest]
        if color_views:
            colors, _ = photo_colors(vertices, vertex_normals, color_views, progress)
            seen = ~np.isnan(colors[:, 0])
            vertex_colors[seen] = linear_to_srgb(colors[seen] * color_gains)
        mesh.vertex_colors = open3d.utility.Vector3dVector(vertex_colors)
        open3d.io.write_triangle_mesh(str(output_directory / "mesh.ply"), mesh)
        mesh_record = {"octree_depth" : octree_depth, "trim_millimeters" : mesh_trim_millimeters,
                       "vertex_count" : len(vertices), "triangle_count" : len(mesh.triangles)}
        progress.report(f"  mesh written: {len(vertices)} vertices, {len(mesh.triangles)} triangles "
                        f"(Poisson, octree depth {octree_depth})")

    axes_record = {"latitude_axis" : model.latitude_axis.tolist(), "latitude_point" : model.latitude_point.tolist(),
                   "longitude_axis" : model.longitude_axis.tolist(), "longitude_point" : model.longitude_point.tolist(),
                   "rotation_center" : center.tolist(), "axis_gap_millimeters" : axis_gap,
                   "nod_gain_degrees" : model.nod_gain_degrees, "nod_pivot_height_millimeters" : model.nod_pivot_height,
                   "nod_pivot" : model.nod_pivot.tolist(),
                   "fit_misalignment_millimeters" : fit_misalignment,
                   "misalignment_before_refinement_millimeters" : before,
                   "misalignment_after_refinement_millimeters" : after,
                   "mount_top_millimeters" : mount_top, "mount_radius_millimeters" : mount_radius,
                   "crop_radius_millimeters" : crop_radius, "voxel_millimeters" : voxel_size,
                   "depth_band_millimeters" : [raw * scanner_module.depth_unit_millimeters for raw in depth_band_raw],
                   "camera_matrix" : camera_matrix.tolist(), "point_count" : len(final_points),
                   "extra_runs" : [str(extra_run) for extra_run in extra_runs], "color" : color_record,
                   "mesh" : mesh_record}
    (output_directory / "stage_axes.json").write_text(json.dumps(axes_record, indent = 2))

    # Previews in the object frame. "front" is where the camera was at latitude 0, longitude 0
    # (it looked along +z); "right" is the camera's right (+x), and so on.
    low, high = np.percentile(final_brightness, [2, 98])
    stretched = np.repeat(np.clip((final_brightness - low) / (high - low), 0, 1)[:, None], 3, axis = 1)
    gray = np.full_like(stretched, 0.8)
    toward_camera = np.array([0.0, 0.0, -1.0])
    views = {"front" : toward_camera,
             "right" : Rotation.from_rotvec(np.radians(90) * up).apply(toward_camera),
             "back" : -toward_camera,
             "left" : Rotation.from_rotvec(np.radians(-90) * up).apply(toward_camera),
             "top" : up + 0.05 * toward_camera,
             "three_quarter" : toward_camera + 0.8 * up + 0.8 * Rotation.from_rotvec(np.radians(90) * up).apply(toward_camera)}
    for name, direction in views.items():
        renderings = [("shape", gray), ("brightness", stretched)] + ([("color", final_colors)] if color_views else [])
        for suffix, point_colors in renderings:
            image = render_preview(final_points, final_normals, point_colors, direction, up,
                                   point_millimeters = voxel_size)
            open3d.io.write_image(str(output_directory / f"preview_{name}_{suffix}.png"), open3d.geometry.Image(image))
        if make_mesh:
            image = render_preview(vertices, vertex_normals, vertex_colors, direction, up, point_millimeters = voxel_size)
            open3d.io.write_image(str(output_directory / f"preview_{name}_mesh.png"), open3d.geometry.Image(image))
    progress.report(f"done -> {output_directory}")


def main():
    parser = argparse.ArgumentParser(description = "Build a point cloud from a lat/lon scan run.")
    parser.add_argument("run_directory", type = pathlib.Path)
    parser.add_argument("--crop-radius", type = float, default = default_crop_radius_millimeters,
                        help = "Keep points within this distance (mm) of the rotation center (default %(default)s, "
                               "for an object the size of the example duck).")
    parser.add_argument("--depth-range", type = float, nargs = 2, metavar = ("NEAREST", "FARTHEST"), default = None,
                        help = "Keep depth readings between these distances from the scanner, in mm (default "
                               f"{default_depth_band_raw[0] * scanner_module.depth_unit_millimeters:.0f}-"
                               f"{default_depth_band_raw[1] * scanner_module.depth_unit_millimeters:.0f}, "
                               "for the scanner at the front of its mount slot).")
    parser.add_argument("--voxel", type = float, default = default_voxel_millimeters,
                        help = "Output point spacing in mm (default %(default)s).")
    parser.add_argument("--no-refine", dest = "refine", action = "store_false",
                        help = "Skip refining each view with joint ICP after the stage model (it takes a few minutes).")
    parser.add_argument("--extra-runs", type = pathlib.Path, nargs = "+", default = [],
                        help = "More runs of the same object, taken without moving the scanner or re-zeroing the "
                               "stage (e.g. a close-up of one area); placed with the main run's axes and merged in.")
    parser.add_argument("--output-name", default = "reconstruction",
                        help = "Output directory inside the run (default %(default)s).")
    parser.add_argument("--no-mesh", dest = "make_mesh", action = "store_false",
                        help = "Skip fitting a mesh to the point cloud.")
    parser.add_argument("--mount-top", type = float, default = None,
                        help = "Cut the mount at this height, in mm along the turntable axis from the rotation center "
                               "(negative is below it), and keep everything above, instead of searching for the mount. "
                               "For a round object on the axis that passes for the mount.")
    parser.add_argument("--white-from-mount", action = "store_true",
                        help = "White balance from the mount's white nylon instead of the fixed gains, for a run whose "
                               "frames have unusually little blue (the reconstruction warns about those).")
    parser.add_argument("--reuse-fit", metavar = "OUTPUT_NAME", default = None,
                        help = "Take the stage fit and view poses from an earlier output directory of this run instead "
                               "of fitting them again, to change only later steps such as the mount cut or the color.")
    arguments = parser.parse_args()
    depth_band_raw = default_depth_band_raw
    if arguments.depth_range is not None:
        depth_band_raw = tuple(distance / scanner_module.depth_unit_millimeters for distance in arguments.depth_range)
    reconstruct(arguments.run_directory, arguments.crop_radius, arguments.voxel, refine = arguments.refine,
                extra_runs = arguments.extra_runs, output_name = arguments.output_name, depth_band_raw = depth_band_raw,
                make_mesh = arguments.make_mesh, mount_top = arguments.mount_top,
                white_from_mount = arguments.white_from_mount, reuse_fit = arguments.reuse_fit)


if __name__ == "__main__":
    main()
