HazenBabcock/revopoint-lat-lon-scanner/lat_lon_scanner/scanner.py

"""
Depth capture from the Revopoint MINI at several exposures, through
revopoint-python (github.com/HazenBabcock/revopoint-python).

A single exposure can't cover a whole scene: white parts saturate at long
exposures while yellow or red ones (which absorb the scanner's blue light)
only get depth at long ones. Capturing 12000, 24000 and 40000 and merging gave
32% more coverage on the test duck than the best single exposure, and where
exposures overlap they agree.
"""
import numpy as np
import requests

import revopoint_python.revopoint as revopoint

default_scanner_address = "192.168.1.36"
default_exposures = (12000, 24000, 40000)

# The exposure left set after a capture, a good general-purpose value.
resting_exposure = 12000

# Raw depth is Z along the left rectified camera's optical axis in units of
# 4.851 um, proportional with no offset. Measured 2026-10-27 by sliding the
# scanner the full 55.85 mm of its mount slot (11,514 raw units). Values wrap
# past 65535 (~318 mm), so anything farther reads as very near.
depth_unit_millimeters = 0.004851

# Frames thrown away at the start of every capture. The scanner occasionally
# delivers a frame left over from its previous stream first, which after a
# stage move shows the object at the previous pose (2 of 40 moves on the
# 2026-10-27 duck scan).
leading_frames_discarded = 1

# Per-camera calibration (intrinsics, distortion, rectification) on the scanner,
# and the color camera's: Prgb.bin (its camera matrix for a 640x400 image),
# Distort.bin (k1 k2 p1 p2 k3) and LC_RT.bin (rotation and translation in mm
# from the rectified left camera, where depth is, to the color camera).
calibration_paths = ("/data/camparam/mapparamL.bin", "/data/camparam/mapparamR.bin",
                     "/data/camparam/Prgb.bin", "/data/camparam/Distort.bin", "/data/camparam/LC_RT.bin")

# The color camera only runs alongside a depth stream (projector on), so its
# frames are taken during one exposure's capture, the one nearest this.
preferred_color_exposure = 24000


class Scanner(object):

    def __init__(self, address = default_scanner_address):
        self.address = address
        self.revopoint = revopoint.Revopoint(ipAddr = address)

    def capture_exposures(self, exposures = default_exposures, frames_per_exposure = 4, color = False):
        """
        Capture frames_per_exposure depth frames at each exposure, after
        discarding the stream's first leading_frames_discarded frames.

        Returns {exposure: {"depth": (frames, 400, 640) uint16,
                            "mono": (800, 640) uint8}}, where "mono" is the
        stereo pair (left camera on top) from the last frame. The depth map is
        registered to the left image.

        With color, the capture at the exposure nearest preferred_color_exposure
        also has "color": the median of the color camera's frames taken during
        it, (800, 1280, 3) uint8 RGB, and "color_frames", how many went into it.
        Like the depth, the first color frame is left out when there are
        others, in case it is left over from the previous pose. It also has
        "white_balance_gains", the red, green and blue gains the camera was
        using, if they could be read.

        Every stream is closed after its capture and the exposure is set back to
        resting_exposure, even on failure: a stream left open keeps the projector
        running.
        """
        color_exposure = min(exposures, key = lambda exposure: abs(exposure - preferred_color_exposure)) if color else None
        captures = {}
        try:
            for exposure in exposures:
                self.revopoint.set_exposure(exposure)
                requested = frames_per_exposure + leading_frames_discarded
                images = self.revopoint.get_images(requested, color = (exposure == color_exposure))
                self._close_streams()
                if len(images["depth"]) != requested:
                    raise RuntimeError(f"Got {len(images['depth'])} of {requested} frames at exposure {exposure}")
                captures[exposure] = {"depth" : np.array(images["depth"][leading_frames_discarded:]),
                                      "mono" : np.array(images["other"][-1])}
                if exposure == color_exposure:
                    color_frames = images["color"][1:] if len(images["color"]) > 1 else images["color"]
                    captures[exposure]["color"] = np.median(np.array(color_frames), axis = 0).astype(np.uint8)
                    captures[exposure]["color_frames"] = len(color_frames)
                    gains = images.get("white_balance_gains")
                    if gains is not None:
                        captures[exposure]["white_balance_gains"] = np.array([gains["red"], gains["green"], gains["blue"]])
        finally:
            try:
                self.revopoint.set_exposure(resting_exposure)
            finally:
                self._close_streams()
        return captures

    def download_calibration(self):
        """Return {path: bytes} for the scanner's per-camera calibration files."""
        calibration = {}
        for path in calibration_paths:
            response = requests.get(f"http://{self.address}/cgi-bin/zx_cmd.cgi?download={path}", timeout = 10)
            response.raise_for_status()
            calibration[path] = response.content
        return calibration

    def firmware_version(self):
        # The scanner pads the version string with a NUL.
        return self.revopoint.get_version().replace("\x00", "").strip()

    def _close_streams(self):
        for _ in range(2):
            try:
                self.revopoint.close_streams()
            except Exception:
                pass
