HazenBabcock/revopoint-lat-lon-scanner/(commit log)

2026-10-27 Start the firmware config from BTT's SKR Mini E3 3.0 example
    Unmodified Configuration.h and Configuration_adv.h from
    MarlinFirmware/Configurations tag 2.1.2.9,
    config/examples/Creality/Ender-3/BigTreeTech SKR Mini E3 3.0, committed
    as-is so the stage changes show up as their own diff. LICENSE is Marlin's
    GPLv3 text, which covers everything under firmware/.
    [Configuration.h, Configuration_adv.h]
2026-10-27 Configure Marlin for the lat/lon stage
    Two axes in degrees on the SKR Mini E3 V3.0: X is latitude (STEPPERONLINE
    2 A, 800 mA RMS), Y is longitude (1 A pancake, 480 mA RMS). The idle timeout
    is gone and the TMC2209s hold at full run current, so the motors keep the
    object still until an explicit M18/M84. Z, the extruder, heaters, LCD, SD
    printing and bed levelling are removed; per-axis arrays shrink to X and Y to
    satisfy Marlin's sanity checks.
    build.sh clones Marlin 2.1.2.9 and builds STM32G0B1RE_btt with PlatformIO
    (118,800 bytes). The README covers flashing and the G-code to use.
    [Configuration.h, Configuration_adv.h]
2026-10-27 Report driver temperature flags without halting on driver errors
    TMC_DEBUG gives M122 the full driver status, including the 120/143/150/157 C
    comparator flags. MONITOR_DRIVER_STATUS polls the drivers, reports
    pre-warnings (M911) and steps a motor's current down 50 mA when one persists.
    STOP_ON_ERROR stays off: it would halt the firmware on over-temperature or a
    short and release both motors, while the drivers already protect themselves.
    Image grows from 118,800 to 125,868 bytes.
    [Configuration_adv.h]
2026-10-27 Document the stage's zero, axis directions and latitude limits
    Measured on the hardware with the scanner's color camera and confirmed by
    eye: +X tilts the top toward the scanner, +Y turns the turntable
    counterclockwise seen from above. The latitude hard limit is +-90 degrees
    (the longitude motor's cable); scans use +90 to -20, below which the view
    is mostly the mount and plate.
2026-10-27 Add the lat_lon_scanner package: stage control and multi-exposure capture
    stage.py drives the Marlin board over serial (finds the port by id, waits
    for each 'ok', refuses latitudes beyond the +-90 degree cable limit) and
    doubles as a small CLI: position, zero, move, release. scanner.py captures
    depth at 12000/24000/40000 through revopoint-python, always closing the
    stream so the projector stops, and records the measured depth unit
    (4.851 um per raw unit). capture.py walks a lat/lon grid (49 views by
    default, rows alternating direction so the turntable never swings back),
    saving one .npz per view plus run.json and the scanner's calibration files
    under ~/Data/revopoint/<date>/<name>/.
    Tested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
2026-10-27 License the non-firmware code under MIT
    firmware/ stays GPLv3, being derived from Marlin; LICENSE and the README
    say which covers what.
2026-10-27 Add reconstruction: merge a scan's views into a cleaned point cloud
    reconstruct.py merges each view's exposures, drops pixels at depth edges
    and surfaces seen nearly edge-on, and converts depth to millimetre points
    with the scanner's rectified left camera (decoded from mapparamL.bin).
    The two stage axes are fitted from the scan itself by minimizing the
    misalignment between neighboring views; on the duck they come out 0.5 mm
    from intersecting, with views agreeing to ~0.3 mm. A joint ICP refinement
    is available (--refine) but did not improve on the fitted axes, so it is
    off by default. The merged cloud is cropped to the object (the post and cap
    are found as a stack of cylinders on the turntabl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
    [reconstruct.py]
2026-10-28 Scan explicit poses and merge extra runs, to fill in dark areas
    capture.py takes --poses, a quoted list of LATITUDE:LONGITUDE, in place of
    the sphere plan. reconstruct.py takes --extra-runs: more runs of the same
    object, taken without moving the scanner or re-zeroing the stage, whose
    views are placed with the main run's fitted axes and merged in before
    cropping (--output-name keeps the result separate). Brightness comes from
    the nearest exposure a run has.
    Used on the duck's red beak, which keeps gaining depth at longer exposures
    while the rest of the duck has plateaued: 20 views at 60000 around it took
    3 minutes, lined up with the main scan to ~0.1 mm (the main scan's own
    views: ~0.1 mm),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
2026-10-28 Drop stale frames that showed the duck at the previous pose
    Symptom: curved sheets of points standing off the duck's back ('wings'),
    seen in MeshLab. Cause: the scanner occasionally delivers a frame left over
    from its previous stream as the first frame of a capture. After a stage
    move that frame shows the object at the previous pose, so it was placed
    36-60 degrees off. Confirmed on the 2026-10-27 scan: in 2 of 40 views the
    first 12000 frame lined up with the duck (99.5% within 0.5 mm) only when
    placed at the previous view's pose. Where it had depth that the good frames
    lacked, the per-pixel median had nothing else to use.
    Fixed at both ends:
    - scanner.py now discards the first frame of ever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
    [reconstruct.py, scanner.py]
2026-10-28 Add the stage's FreeCAD models and fabrication exports
    cad/ has Hazen's own parts and assemblies (latest versions only) and the
    DXF and STL files sent to Ponoko and Xometry. Models from GrabCAD,
    BigTreeTech and McMaster-Carr are left out because their terms don't
    allow redistribution; cad/README.md and the main README credit and link
    each one, with the McMaster-Carr part numbers.
    [assembly.FCStd, base_plate-Shape2DView.dxf, base_plate.FCStd, base_plate_assembly.FCStd, bumper.FCStd, counter_weight-Shape2DView.dxf, counter_weight.FCStd, counter_weight_clamp-Body_cw_clamp.stl]
2026-10-28 Show the assembly in two renders in the CAD README
    Rendered in FreeCAD from the full assembly, so the scanner, control board,
    motors, hardware and example object appear even though their models are
    not in the repo.
2026-10-28 Drop the unused counterweight design and note the copper bar
    The counterweights are pieces of 1/2" x 1/2" copper bar (McMaster-Carr
    89275K36) held in the printed clamps, so counter_weight.FCStd and its
    DXF were an earlier design that isn't part of the build.
    [counter_weight-Shape2DView.dxf, counter_weight.FCStd]
2026-10-28 Name the export folders by part type and list how each was made
    exports/parts_2D_DXF and exports/parts_3D_STL replace the dated vendor
    folder names. cad/README.md gives the material and process for each:
    6.7 mm bamboo plywood laser cut by Ponoko for the plates, and white Nylon
    12 printed by Xometry for the 3D parts.
    [base_plate-Shape2DView.dxf, counter_weight_clamp-Body_cw_clamp.stl, lat_lon_plate-Shape2DView.dxf, lat_stepper_arm-Body_lat_idle_arm.stl, lat_stepper_arm-Body_lat_stepper_arm.stl, lon_plate-Body_lon_plate.stl, scanner_mount_plate-Shape2DView.dxf, stepper_lat_mount-Body_stepper_lat_mount.stl]
2026-10-28 Leave the example bust out of the CAD renders
    It floats above the turntable rather than sitting on the longitude
    mounting plate, so the renders read better without it.
2026-10-28 Add the bill of materials spreadsheet to cad/
    A copy of scanner_mount_bom.xlsx: the McMaster-Carr order, the full BOM
    (plates, printed parts, board, STEPPERONLINE motors, motor cables and the
    copper counterweights), per-sub-assembly counts and notes. Both READMEs
    point to it.
    [scanner_mount_bom.xlsx]
2026-10-28 Add the duck point cloud as an example
    The 40-view duck scan merged with the 20-view beak scan at exposure
    60000: 54,659 points with positions in mm, normals, and the scanner's
    brightness as color.
    [duck_point_cloud.ply]
2026-10-28 Give the BOM's plates and printed parts their materials
    The Source column now says how each was made: Ponoko laser cutting in
    6.7 mm amber bamboo plywood, and Xometry 3D printing in white Nylon 12
    (the parts were printed, not machined).
    [scanner_mount_bom.xlsx]
2026-10-28 Open the README with a photo of the stage and a mesh of the duck
    The mesh is a Poisson surface (Open3D) of examples/duck_point_cloud.ply,
    seen from 30 degrees around and 40 degrees above so it faces the way the
    duck does in the photo.
2026-10-28 Add a guide to the repo for AI agents
    notes/agent-guide.md maps the code and points to the READMEs, then
    collects what they don't spell out: the stage's zeroing and latitude
    limits, keeping the scanner's projector from being left on, stale and dim
    frames, depth units and range, the object frame, what is known about the
    color camera's calibration, code style, and how the BOM spreadsheet works.
2026-10-28 Let the reconstruction's depth band follow the scanner
    The 73-194 mm band suited the scanner at the front of its mount slot. A
    larger object needs it at the back, about 56 mm farther away, so the band
    is now --depth-range (mm; default unchanged, and the duck rebuilds
    identically). The README's new "Larger objects" section gives the settings
    for a bust with the scanner at the back of the slot.
    merge_exposures also returns an empty depth map when no exposure has any
    reading in the band, instead of failing.
    [reconstruct.py]
2026-10-28 Reconstruct scans without a latitude 0 row; find the mount from the turntable axis
    The 2026-10-27 bust scan (20 degree plan, rows at 10 and -10) has no view at
    latitude 0, longitude 0, which the first rotation center guess needed. Use the
    view nearest that pose instead.
    The mount removal measured distances from the rotation center, which sits
    midway between the stage axes and so is off the turntable axis by half their
    gap: 0.79 mm for the bust. Measured from there, the post's slices spread
    1.5-1.7 mm, over the 1 mm limit, and no mount was found. From the turntable
    axis they spread 0.3-0.6 mm. The duck (0.27 mm off) rebuilds with the same
    mount top and a radius of 7.8 mm instead of 8.0.
    Co-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
2026-10-28 Fit a latitude-dependent nod of the object in the reconstruction
    The 2026-10-27 bust, held on its cap by a ~0.5 mm gel pad, tipped toward
    the scanner at high latitudes and away at negative ones, so its head came
    out in layers 1-2 mm apart, the rows above the equator outside the rows
    below it. The stage model now includes a nod of gain x sin(latitude) (the
    gravity load) about a line parallel to the latitude axis through a pivot on
    the turntable axis, applied between the turntable turn and the cradle tilt.
    The nod is fitted after the axes on views up to 70 degrees apart, since one
    row's nod barely differs from the next row's, and the axes are then refitted
    with it. On the bust: 2.54 degrees x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
2026-10-28 Refine each view by default, anchored to the average correction
    After the nod, the 2026-10-27 bust still had stray layers on its head. Per
    view, they came from the +50 row: from its second view on, the head swung up
    to 1.5 mm toward the scanner and slid 1-2 mm sideways, staying about 1 mm off
    for the rest of the row, likely the bust shifting on its gel pad. The joint
    ICP refinement fixes such per-view shifts, so it now runs by default
    (--no-refine skips it; --refine is gone).
    refine_poses pinned view 0, which in the 20 degree plan is the +90 view and
    was itself off, so every other view moved about 2 mm with it, the post no
    longer sat on the fitted turntable axis, and remove_mount failed. Th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
    [reconstruct.py]
2026-10-28 Show the reconstruction's progress while it runs
    Every output line now starts with the time since the reconstruction began,
    and the long steps (loading views, the four fits, the refinement's pairwise
    alignment) show how they are going: on a terminal, one line updated in place
    (views loaded, or cost evaluations and the best misalignment so far); when the
    output goes to a file, a line about every 30 seconds. Before, the bust's
    reconstruction went quiet for up to 15 minutes at a time.
    [reconstruct.py]
2026-10-28 Add the bust point cloud as an example
    The 2026-10-27 bust scan (88 views at 20 degree spacing, latitudes -20 to
    +90, scanner at the back of its mount slot), reconstructed with
    --depth-range 100 215 --crop-radius 55, the fitted nod and the per-view
    refinement: 107308 points, about 33 x 63 x 30 mm.
    [bust_point_cloud.ply]
2026-10-28 Capture color frames and color the point cloud
    capture.py now saves a frame from the scanner's color camera with each view
    (the median of the frames taken during the 24000 exposure's depth stream,
    leaving out the first in case it is from the previous pose; --no-color skips
    it), and each run's calibration folder gets the color camera's files from the
    scanner (Prgb.bin, Distort.bin, LC_RT.bin).
    reconstruct.py colors each view's points from its frame: projected through
    the color camera's calibration (OpenCV's distortion model), skipping points
    the color camera can't see past nearer surfaces (it sits 15 mm from the left
    camera), sampled bilinearly, and white balanced. Each final point takes the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
    [capture.py, reconstruct.py, scanner.py]
2026-10-28 Color from every frame that sees a point, and fit a mesh
    Each final point, and each mesh vertex, now takes its color from every
    color frame that sees it (facing the camera, not hidden by nearer
    surface), weighted by how squarely it faces that camera. Before, a point
    only got colors from the views that measured depth near it. The duck's
    pink beak gets depth on only 10-33% of its pixels in any one view, so
    few views measured each of its points.
    A Poisson mesh is fitted to the points, with octree cells matched to the
    point spacing (finer cells showed the voxel grid as ripples), trimmed to
    within 1 mm of the points (2-3 mm left a lattice of stray triangles
    around the mount opening), and written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
2026-10-28 Show the colored duck mesh in the overview, and add it as an example
    The overview's right side is now the duck's mesh as reconstruct.py
    writes it (2026-10-28 lamp-lit scan plus the 38-view beak and eye
    fill-in), in its scanned colors, with no smoothing or touch-up. A
    smaller gray render of the same mesh shows the scanned surface, and a
    10 mm scale bar gives the size. The render is orthographic, so one
    scale holds across the duck; it was measured from the silhouette, and
    the width and height agree to 0.03%. Viewpoint and lighting match the
    previous overview (30 degrees around, 40 above).
    The mesh itself is examples/duck_color_mesh.ply (3.5 MB), linked from
    the caption so readers can open it.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
    [duck_color_mesh.ply]
2026-10-28 Add the control board's 24 V power supply to the BOM
    A 24 V, 6 A AC adapter (100-240 V AC in, 5.5 x 2.1 mm jack with a
    terminal connector) from Amazon, added by hand like the motor cables: a
    counted row in the Wiring group on By sub-assembly, a row under the
    purchased electronics on the Full BOM, and a Notes entry quoting the
    listing title. The SUMIFS ranges over By sub-assembly grew by the one
    row; the totals went from 112 to 113 part instances and the McMaster
    order is unchanged. Recalculated in LibreOffice, no formula errors.
    [scanner_mount_bom.xlsx]
2026-10-28 Leave out views without depth instead of stopping the reconstruction
    A white nylon part scanned at 12000 and 24000 (both saturate it) left
    views with 0-8 points, and the empty one stopped the reconstruction
    in the normal estimation. load_run_views now leaves out views with
    fewer than 100 points, reporting each one with a hint to check the
    exposures, and raises a clear error if no view is left. On that run it
    left out four views and loaded the other 36.
    The new test fails on the old code with the same Open3D error.
    [reconstruct.py]
2026-10-29 Add a printed part's mesh as an example, and note exposures for white objects
    examples/3d_printed_part_mesh.ply is a white nylon part the author
    designed and printed, scanned with 40 views at exposures 3000 and 6000
    under the lamp: 44,694 points, neighboring views agreeing to 0.36 mm
    after refinement, and a 47,640-vertex colored mesh (3.7 MB).
    Its first scan, at 12000 and 24000, saturated the part: only 0.1-2% of
    each frame got depth. One view at 2000-8000 got 92-95% at any single
    exposure. The README's scanning section and the agent guide now say to
    match the exposures to the object, with --exposures 3000 6000 for white
    and light objects; the guide's old "use 12000 or more" held only for
    d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
    [3d_printed_part_mesh.ply]
2026-10-29 Add the scanner's mounting washers to the BOM
    Two McMaster-Carr 96659A106 18-8 stainless SAE washers (1/4" screw size,
    0.281" ID, 0.625" OD) hold the scanner on its mount. The model doesn't
    show them, so they are a hand-added row at the top level, with a Washers
    section on the McMaster order and a row in the Full BOM.
    [scanner_mount_bom.xlsx]
2026-10-29 Add a three.js viewer for the examples on the GitHub Pages site
    The repo is now published with GitHub Pages from the root of main, and
    examples/index.html shows each example in 3D: picked models load on
    demand, turned upright and centered over a 5 mm grid, with color, gray
    and wireframe views. The README links to it, and its lat_lon_scanner/
    link now goes to GitHub, since folders without a README or index.html
    have no page on the site. The agent guide notes how the site is built.
2026-11-05 Speed up the stage fit about sixfold
    Each view's k-d tree is now built once in its own camera frame, and a
    trial moves its neighbors' points into that frame instead of rebuilding
    the trees; each view's neighbors are queried together on all usable
    cores. Powell stops once a round gains less than 0.2%, and dense scan
    plans compare fewer neighboring views (2.1 times the plan's spacing,
    3.7 for the nod fit).
    figurine_2 (127 views, 15 degree plan) reconstructed in 32 minutes
    instead of 127, with the same misalignment after refinement (0.347 mm)
    and its points within 0.09 mm (median) of the earlier ones. The bust
    took 21 minutes instead of 43, with the same nod and misalignments.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
    [reconstruct.py]
2026-11-05 Merge exposures with a sort-based median, eleven times faster
    numpy's nanmedian takes 0.23 s on a stack of four 640 x 400 frames (it
    goes through masked arrays), and merging a view's exposures takes 16 of
    them. Sorting the stack and picking the middle gives the same depth
    maps: identical on 115 views of five runs, at 0.32 s per view instead
    of 3.68 s. Loading the bust's 88 views now takes 38 s instead of 9.5
    minutes, and the whole reconstruction about 10 minutes.
2026-11-06 Let --mount-top set the mount's height, and warn about round objects
    A round object on the turntable axis can pass for the mount. The
    2026-11-06 flower pot's tapered wall made a longer run of round slices
    than the post, so it was taken for the post and cut away up to the
    rotation center, with no warning. The reconstruction now warns when the
    mount's top comes within 5 mm of the rotation center, and --mount-top
    gives the height by hand, keeping everything above it.
2026-11-06 Warn about runs short of blue, and let --white-from-mount fix them
    The 2026-11-06 flower pot's color frames had about a tenth of the usual
    blue, for no known reason: under the fixed gains the mount's white nylon
    read 0.07 as much blue as green, against 0.5-0.6 on the duck and
    figurine_2. Its light tan pot came out yellow-green and its light purple
    flowers tan.
    The reconstruction now warns when the mount's blue is that low, and
    --white-from-mount takes the white balance and brightness from the
    median color of the run's own post and cap. The fixed gains stay the
    default: they looked better on the duck and figurine_2. view_colors and
    photo_colors now return colors without white balance, and th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
    [reconstruct.py]
2026-11-06 Save each reconstruction's fit, and let --reuse-fit skip it
    Changing only the mount cut or the white balance repeated the stage fit
    and refinement, which took 6.5 of 8.7 minutes on the second flower pot.
    Each output now saves the fit and every view's pose in fit.npz, and
    --reuse-fit takes them from an earlier output of the run. On the first
    flower pot a reused run matched a full one exactly, in 33 s instead of
    76 s.
    [reconstruct.py]
2026-11-06 Record the camera's white balance gains with each view
    Each view now saves the red, green and blue gains the camera was using,
    and the scan log prints them. The reconstruction reports their median
    and range, in the log and stage_axes.json, and warns if they move by
    more than 5% during a run. They aren't used to correct color: a whole
    session's color has gone far too yellow, but the gains weren't read
    during it, so nobody knows yet what they do then. Older runs have no
    gains and skip this.
    Needs revopoint-python e813acf for the gains; with an older version the
    capture carries on without them.
    [capture.py, reconstruct.py, scanner.py]
2026-11-06 Take the mount's nylon as slightly warm for --white-from-mount
    As neutral white, the small flower pot's light tan pot came out too gray
    on its rescan. Red 1.09 and blue 0.96 of green, a quarter of the way
    towards the nylon's color under the color card's gains, was the closest
    to the real pot by eye, with its flowers and leaves still right.
